kkostyy/cyberdeck/IDEAS.md

# Cyberdeck на Raspberry Pi 4 — что с ним можно сделать

Список идей для самодельного карманного компьютера (кибердеки): от рабочих задач до радио, железа и развлечений.
У каждой идеи указано, что понадобится, примерная цена, сложность и с чего начать.

**Сложность:** ★ — пара команд · ★★ — вечер настройки · ★★★ — проект на выходные и больше
**Цены** ориентировочные (евро, AliExpress / местные магазины, 2026).

---

## Что есть сейчас

| | |
|---|---|
| Плата | Raspberry Pi 4 Model B, 4 ГБ ОЗУ |
| Экран | 5" DSI 800×480, сенсорный (FT5x06) |
| Ввод | мини-клавиатура с тачпадом, экранная клавиатура, жесты от краёв |
| Связь | Wi-Fi, Bluetooth, Ethernet |
| Система | Arch Linux ARM, Wayland (sway) + оболочка serpantinum (quickshell) |
| Хранилище | microSD 16 ГБ |
| Софт | Claude Code (своё приложение claude-desk), VS Code, .NET 10 / ASP.NET Core, Chromium, kitty |

**Слабые места:** внезапные выключения из-за разъёма питания, мало места на SD-карте, нет батареи, нет звука на разъёме 3,5 мм (включается в `/boot/config.txt`).

---

## Содержание

1. [Сделать деку по-настоящему переносной](#1-сделать-деку-по-настоящему-переносной)
2. [Рабочая станция в кармане](#2-рабочая-станция-в-кармане)
3. [Радио и эфир](#3-радио-и-эфир)
4. [Сети](#4-сети)
5. [Железо через GPIO и USB](#5-железо-через-gpio-и-usb)
6. [Локальный ИИ без интернета](#6-локальный-ии-без-интернета)
7. [Камера и зрение](#7-камера-и-зрение)
8. [Навигация и поход](#8-навигация-и-поход)
9. [Электроника и ремонт](#9-электроника-и-ремонт)
10. [Развлечения и творчество](#10-развлечения-и-творчество)
11. [Дома на столе](#11-дома-на-столе)
12. [Обучение](#12-обучение)
13. [План: с чего начать](#13-план-с-чего-начать)
14. [Список покупок](#14-список-покупок)

---

## 1. Сделать деку по-настоящему переносной

### 1.1 Батарея / UPS ★★
**Что:** плата бесперебойного питания с аккумуляторами 18650 (или повербанк с режимом pass-through).
**Зачем:** дека работает без розетки, а при отходящем контакте Pi **не выключается** — UPS просто подхватывает питание. Это главный апгрейд.
**Нужно:** UPS HAT для Pi 4 (Waveshare UPS HAT, Geekworm X728/X1200, PiSugar для небольших сборок) + 2× аккумулятора 18650 с защитой. ~30–50 €.
**Что настроить:** индикатор заряда на панели, уведомление при низком заряде, аккуратное выключение при 5 %, автозапуск после подключения зарядки.
**Важно:** Pi 4 под нагрузкой берёт до 3 А — выбирать UPS с выходом не меньше 3 А.

### 1.2 Система на USB-флешке или SSD ★★
**Что:** перенос всей системы с microSD на USB 3.0-накопитель.
**Зачем:** в 3–5 раз быстрее запуск программ и установка пакетов, больше места, SD-карта перестаёт изнашиваться и не портится при выключениях.
**Нужно:** качественная флешка USB 3.x (SanDisk Extreme, Samsung BAR/FIT Plus, Kingston DataTraveler Max) или SSD M.2/SATA в USB-корпусе. 64 ГБ флешка — ~10–15 €, SSD 256 ГБ + корпус — ~30–40 €.
**Как:** тест скорости накопителя → копирование системы → загрузка с USB. SD-карта остаётся запасной.

### 1.3 Корпус ★★–★★★
**Что:** напечатанный на 3D-принтере или собранный корпус под экран, клавиатуру и батарею.
**Идеи:** раскладушка как у ноутбука, «чемоданчик» в стиле 80-х, наручный вариант. Готовые модели — на Printables/Thingiverse по запросу «cyberdeck 5 inch DSI».
**Плюс:** вывести наружу USB-порты, кнопку питания и светодиод состояния.

### 1.4 Кнопка питания и светодиод ★
**Что:** физическая кнопка на GPIO: короткое нажатие — экран вкл/выкл, долгое — корректное выключение. Светодиод показывает, что Pi работает или пишет на диск.
**Нужно:** кнопка + светодиод + резистор, ~2 €. Настройка — оверлеи `gpio-shutdown` и `gpio-led` в `/boot/config.txt`.

### 1.5 Охлаждение ★
**Что:** радиатор или вентилятор.
**Зачем:** в простое сейчас ~65 °C; при сборках и видео Pi упирается в 80 °C и сбрасывает частоту.
**Нужно:** радиаторы ~3 €, корпус-радиатор (Argon, Flirc) или вентилятор 30 мм ~5–15 €. Вентилятор можно включать по температуре через оверлей `gpio-fan`.

### 1.6 Энергосбережение ★
**Что:** режим «экономия» в один клик: ниже частота, без живых обоев, приглушённый экран, выключенный Bluetooth.
**Зачем:** +30–50 % времени работы от батареи.

---

## 2. Рабочая станция в кармане

### 2.1 Программирование где угодно ★
**Что уже есть:** Claude (claude-desk), VS Code, .NET 10, ASP.NET Core.
**Можно добавить:** Python с виртуальными окружениями, Node.js, Rust, Go, Git + GitHub CLI, Docker/Podman для маленьких сервисов.
**Идея:** «карманный стенд» — писать веб-API на ASP.NET и сразу открывать его с телефона по Wi-Fi.

### 2.2 Терминал для серверов ★
**Что:** SSH к другим машинам, tmux (сессии не рвутся при обрыве связи), mosh (SSH, который переживает смену сети), хранилище ключей.
**Зачем:** дека как «пульт» для домашнего сервера, VPS, роутера.

### 2.3 Офлайн-база знаний ★
**Что:** Kiwix — вся Википедия, Stack Overflow, Wiktionary, медицинские справочники без интернета.
**Размер:** Википедия на русском без картинок ~10 ГБ, английская с картинками ~100 ГБ. Нужен накопитель побольше (см. 1.2).

### 2.4 Заметки и личная база знаний ★
**Что:** Markdown-заметки в стиле Obsidian/Zettelkasten, синхронизация через git с телефоном и ПК.
**Плюс:** ежедневник, список дел, календарь (CalDAV — синхронизация с Google/Nextcloud).

### 2.5 Удалённый рабочий стол к ПК ★
**Что:** подключаться с деки к домашнему компьютеру (RDP/VNC/RustDesk) — дека как тонкий клиент к мощной машине.

### 2.6 Менеджер паролей ★
**Что:** KeePassXC с базой, синхронизируемой с телефоном (KeePassDX). Полностью офлайн.

---

## 3. Радио и эфир

> Приём почти везде законен. Передача — только на разрешённых частотах и/или с позывным (радиолюбительская лицензия).

### 3.1 SDR-приёмник ★★
**Что:** USB-свисток RTL-SDR превращает деку в радиоприёмник от 24 МГц до 1,7 ГГц.
**Что можно слушать и смотреть:**
- FM/AM-радио, авиадиспетчеров (118–137 МГц), морской канал;
- **ADS-B** — самолёты вокруг на карте в реальном времени (dump1090/readsb), можно отправлять данные во Flightradar24 и получать бесплатный бизнес-аккаунт;
- **метеоспутники NOAA/Meteor** — принимать снимки Земли из космоса (нужна простая антенна V-диполь);
- **rtl_433** — показания беспроводных термометров, метеостанций, датчиков вокруг;
- спектр эфира как «водопад» (SDR++, GQRX).

**Нужно:** RTL-SDR Blog V4 (~30–40 €) + антенны из комплекта.

### 3.2 Meshtastic / LoRa ★★
**Что:** текстовая связь на несколько километров (в городе 1–5 км, на открытой местности до 10+ км) без интернета и сотовой сети. Сообщения передаются по цепочке устройств (mesh).
**Нужно:** плата LoRa на 868 МГц (Европа): Heltec V3, LilyGO T-Beam (с GPS), RAK WisBlock — ~25–40 €. Подключается к деке по USB или Bluetooth.
**Идея:** дека как «базовая станция» сети Meshtastic с большим экраном и клавиатурой; приём сообщений даже когда телефон выключен.

### 3.3 Отслеживание спутников ★★
**Что:** Gpredict показывает, когда над тобой пролетает МКС и спутники. С SDR можно принимать SSTV-картинки с МКС (во время событий ARISS) и телеметрию.

### 3.4 Цифровые радиолюбительские режимы ★★★ (нужна лицензия на передачу)
**Что:** FT8 (связь через весь мир при мощности в несколько ватт), APRS (позиция и короткие сообщения), Winlink (e-mail через радио).
**Нужно:** трансивер + звуковой интерфейс (Digirig) — дека выступает «компьютером» станции.

---

## 4. Сети

> Сканировать и анализировать — только свои сети и с разрешения владельца.

### 4.1 Анализ Wi-Fi и Bluetooth ★
**Что:** какие сети вокруг, на каких каналах, уровень сигнала, загруженность каналов (полезно выбрать лучший канал для своего роутера). Список BLE-устройств поблизости.

### 4.2 Сетевая аптечка ★
**Что:** проверка своей домашней сети: какие устройства подключены (nmap), скорость между устройствами (iperf3), скорость интернета, просмотр трафика (Wireshark), DNS-диагностика.

### 4.3 Дорожный роутер ★★
**Что:** с дополнительным USB Wi-Fi-адаптером дека подключается к Wi-Fi отеля/кафе одним модулем, а другим раздаёт свою защищённую сеть для телефона и ноутбука — весь трафик через VPN.
**Нужно:** USB Wi-Fi-адаптер с поддержкой режима AP (чипы MediaTek MT7612U/MT7921AU) ~15–25 €.

### 4.4 Личный VPN / Tailscale ★
**Что:** доступ к деке из любой точки мира и с деки — к домашней сети, без проброса портов. WireGuard или Tailscale.

### 4.5 Учебная лаборатория по безопасности ★★
**Что:** CTF-задачи, TryHackMe/HackTheBox через VPN, свои виртуальные «мишени» — учиться защите сетей легально.

---

## 5. Железо через GPIO и USB

### 5.1 Датчики окружения ★
**Что:** температура, влажность, давление (BME280), CO₂ (SCD40), качество воздуха и пыль (PMS5003), освещённость.
**Результат:** показания на панели, графики за сутки/неделю, уведомление «пора проветрить».
**Нужно:** датчики ~5–40 € каждый, подключение по I²C.

### 5.2 Реле, свет, моторы ★★
**Что:** включать лампы и приборы (через реле — осторожно с 230 В!), управлять LED-лентами, сервоприводами, шаговыми моторами. Простые роботы и автоматизация.

### 5.3 Программатор микроконтроллеров ★
**Что:** прошивать Arduino, ESP32, ESP8266, Raspberry Pi Pico прямо с деки (arduino-cli, PlatformIO, esptool).
**Идея:** собрать с ESP32 беспроводные датчики, которые шлют данные на деку.

### 5.4 ИК-пульт ★
**Что:** универсальный пульт для телевизора, кондиционера, проектора (LIRC). Кнопки на экране деки.
**Нужно:** ИК-светодиод + ИК-приёмник ~3 €.

### 5.5 NFC/RFID ★★
**Что:** считыватель PN532: читать свои карты и метки, автоматизация («приложил метку — запустилось действие»), хранить данные визиток.
**Нужно:** PN532 ~5–8 €.

### 5.6 Bluetooth-датчики (BLE) ★
**Что:** читать дешёвые BLE-термометры (Xiaomi LYWSD03MMC ~5 €) по всей квартире без проводов.

### 5.7 Маленький дополнительный экран ★★
**Что:** OLED 0,96" или e-ink на корпусе: время, заряд, IP, уведомления — видно даже при выключенном основном экране.

---

## 6. Локальный ИИ без интернета

### 6.1 Небольшая языковая модель ★★
**Что:** llama.cpp с моделями 0,5–3 млрд параметров (Qwen, Llama, Gemma в квантизации Q4). Ответы офлайн, медленно (несколько слов в секунду), но работает без сети.
**Нужно:** место 1–3 ГБ на модель, лучше SSD.
**Идея:** офлайн-помощник в claude-desk, когда нет интернета.

### 6.2 Распознавание речи ★★
**Что:** Whisper (tiny/base) или Vosk — диктовка текста голосом в любое поле. Работает офлайн, на русском.
**Нужно:** USB-микрофон или гарнитура ~5–15 €.

### 6.3 Синтез речи ★
**Что:** Piper TTS — естественный голос на русском офлайн. Дека может зачитывать уведомления, книги, ответы Claude.

### 6.4 Голосовой ассистент ★★★
**Что:** связка 6.2 + 6.3 + команды: «включи свет», «какая погода», «сколько места на диске». Полностью локально.

---

## 7. Камера и зрение

**Нужно:** модуль Raspberry Pi Camera v3 (~25–35 €) или любая USB-вебкамера.

### 7.1 Сканер документов и текст из фото ★
**Что:** сфотографировал страницу — получил PDF и распознанный текст (Tesseract OCR, русский и английский).

### 7.2 Таймлапсы ★
**Что:** съёмка заката, роста растений, 3D-печати в виде ускоренного видео.

### 7.3 Датчик движения и охрана ★★
**Что:** Motion/Frigate — запись при движении, уведомление на телефон.

### 7.4 QR и штрихкоды ★
**Что:** считывать QR-коды камерой (Wi-Fi, ссылки), сканер штрихкодов для учёта вещей.

### 7.5 Астрофотография ★★★
**Что:** камера HQ + объектив или телескоп: Луна, планеты, звёздные треки.

---

## 8. Навигация и поход

### 8.1 GPS ★★
**Что:** USB- или UART-модуль GPS (u-blox NEO-M8N, ~10–20 €): координаты, скорость, высота, точное время даже без интернета.
**Применение:** запись треков поездок, привязка фото к месту, логгер прогулок.

### 8.2 Офлайн-карты ★★
**Что:** карты OpenStreetMap без интернета (GNOME Maps/Marble с офлайн-тайлами, свои MBTiles), маршруты.

### 8.3 «Тревожный чемоданчик» ★
**Что:** офлайн-набор: Википедия, справочник первой помощи, карты региона, инструкции по ремонту, важные документы в зашифрованном виде, Meshtastic для связи.

### 8.4 Дорожный журнал ★
**Что:** трек GPS + фото + заметки → автоматический дневник поездки с картой.

---

## 9. Электроника и ремонт

### 9.1 Логический анализатор ★★
**Что:** USB-анализатор на 8 каналов (~8–15 €) + PulseView/sigrok: смотреть сигналы I²C, SPI, UART при отладке устройств.

### 9.2 Консоль к устройствам ★
**Что:** USB-UART адаптер (CP2102/CH340, ~3 €): подключаться к роутерам, приставкам, платам по последовательному порту, восстанавливать прошивки.

### 9.3 Простой осциллограф ★★
**Что:** USB-осциллограф/звуковая карта как осциллограф — посмотреть форму сигнала, проверить питание.

### 9.4 Сервер для 3D-принтера ★★
**Что:** Klipper + Mainsail или OctoPrint — управлять 3D-принтером с деки, смотреть печать через камеру.

### 9.5 Диагностика авто ★★
**Что:** Bluetooth-адаптер OBD-II ELM327 (~10–15 €): коды ошибок машины, расход, температура, обороты в реальном времени на экране деки.

---

## 10. Развлечения и творчество

### 10.1 Ретро-игры ★
**Что:** RetroArch с эмуляторами NES, SNES, Sega, Game Boy/GBA, PS1, N64 (частично). Bluetooth-геймпад (8BitDo ~25–40 €).

### 10.2 Стриминг игр с ПК ★
**Что:** Moonlight — играть в тяжёлые игры с домашнего компьютера на экране деки по Wi-Fi.

### 10.3 Музыка и видео ★
**Что:** музыкальный плеер, подкасты, интернет-радио, Spotify Connect (spotifyd), видео.
**Сначала:** включить звук — «Настройки → Система → Звук» (разъём 3,5 мм) или Bluetooth-наушники.

### 10.4 Карманная музыкальная студия ★★
**Что:** синтезаторы (Surge XT, ZynAddSubFX), трекер (MilkyTracker), драм-машина, запись с микрофона. С USB-MIDI-клавиатурой — полноценный инструмент.

### 10.5 Читалка ★
**Что:** книги (FB2/EPUB/PDF), RSS-ленты, комиксы. Тёмная тема и крупный шрифт.

### 10.6 Пиксель-арт и рисование ★
**Что:** сенсорный экран + приложение для пиксель-арта (Pixelorama) или заметок от руки.

---

## 11. Дома на столе

### 11.1 Home Assistant ★★
**Что:** центр умного дома: свет, розетки, датчики, автоматизации, панель управления на экране деки.

### 11.2 Pi-hole / AdGuard Home ★
**Что:** блокировка рекламы и трекеров для всех устройств дома (DNS-фильтр).

### 11.3 Сетевая папка и бэкапы ★★
**Что:** Samba-шара, резервные копии телефонов и ПК (Syncthing — синхронизация без облака).

### 11.4 Инфо-панель (киоск) ★
**Что:** когда дека стоит на подставке: погода, календарь, курсы, состояние дома, загрузка ПК — на весь экран.

### 11.5 Сервер для своих проектов ★★
**Что:** держать на деке ASP.NET-API, бота для Telegram, веб-страницу; доступ через Tailscale или Cloudflare Tunnel.

---

## 12. Обучение

### 12.1 Linux и сети ★
**Что:** дека — идеальный «полигон»: изучать Linux, bash, systemd, сети, не боясь что-то сломать (есть бэкапы настроек).

### 12.2 Программирование ★
**Что:** C#/.NET, Python, веб, микроконтроллеры — с Claude как наставником прямо на деке.

### 12.3 Языки и карточки ★
**Что:** Anki (интервальные повторения), офлайн-словари, языковые курсы.

### 12.4 Электроника ★★
**Что:** наборы датчиков и макетная плата: от «мигнуть светодиодом» до своих устройств на ESP32.

---

## 13. План: с чего начать

| Этап | Что | Зачем |
|---|---|---|
| 1 | **Батарея / UPS** (1.1) | убирает внезапные выключения, дека становится переносной |
| 2 | **Перенос на USB/SSD** (1.2) | скорость и место под всё остальное |
| 3 | **Охлаждение** (1.5) | стабильная частота под нагрузкой |
| 4 | **SDR** (3.1) или **Meshtastic** (3.2) | самое «кибердечное»: эфир и связь без сети |
| 5 | **Датчики** (5.1) + **GPS** (8.1) | дека начинает «чувствовать» мир вокруг |
| 6 | **Локальный ИИ и голос** (6.1–6.3) | работа офлайн, управление голосом |

---

## 14. Список покупок

| Что | Для чего | Примерно |
|---|---|---|
| UPS HAT + 2×18650 | батарея, защита от выключений | 30–50 € |
| USB 3.0 флешка 64 ГБ / SSD | система, место | 10–40 € |
| Радиатор / вентилятор | охлаждение | 3–15 € |
| RTL-SDR Blog V4 | радиоприём, самолёты, спутники | 30–40 € |
| LoRa-плата 868 МГц (Heltec V3 / T-Beam) | Meshtastic | 25–40 € |
| GPS u-blox NEO-M8N | навигация, точное время | 10–20 € |
| BME280 / SCD40 | климат в комнате, CO₂ | 5–40 € |
| Камера Pi v3 | сканер, таймлапс, охрана | 25–35 € |
| USB-микрофон | голосовой ввод | 5–15 € |
| USB-UART + логический анализатор | электроника и ремонт | 10–20 € |
| ELM327 Bluetooth | диагностика авто | 10–15 € |
| Bluetooth-геймпад | ретро-игры | 25–40 € |

---

*Документ составлен вместе с Claude прямо на этой деке. Идеи можно брать по одной — каждая самостоятельная.*
