kkostyy/cyberdeck/CYBERDECK.md

# Cyberdeck на Raspberry Pi 4: полное описание проекта

Это общий документ по проекту: железо, система, экран, настройки, охлаждение, питание, корпус,
что уже сделано и что осталось. Файлы для печати корпуса и инструкция к ним лежат в [README.md](README.md).

Описание собрано по записи разговора от 2026-10-28. Это пересказ хода работы,
а не дословная выгрузка. Пароли и ключи Wi-Fi сюда не попали и попадать не должны.

> Конфиги ниже даны в том виде, в каком их обычно пишут для такой настройки. Перед тем как
> копировать их на Pi, сверьте с тем, что реально лежит в ваших файлах.

---

## Содержание

1. [Цель](#1-цель)
2. [Железо](#2-железо)
3. [Система и программы](#3-система-и-программы)
4. [Экран DSI 4,3"](#4-экран-dsi-43)
5. [Графическая сессия: Sway и Serpantinum](#5-графическая-сессия-sway-и-serpantinum)
6. [Удалённый доступ: SSH и WayVNC](#6-удалённый-доступ-ssh-и-wayvnc)
7. [Автовход на tty1](#7-автовход-на-tty1)
8. [Старый OLED 0,96"](#8-старый-oled-096)
9. [Охлаждение](#9-охлаждение)
10. [Питание](#10-питание)
11. [Корпус](#11-корпус)
12. [Клавиатура Rii mini X1](#12-клавиатура-rii-mini-x1)
13. [Список покупок и крепежа](#13-список-покупок-и-крепежа)
14. [Сборка по шагам](#14-сборка-по-шагам)
15. [Если что-то не работает](#15-если-что-то-не-работает)
16. [Безопасность](#16-безопасность)
17. [Что сделано и что дальше](#17-что-сделано-и-что-дальше)
18. [Идеи на потом](#18-идеи-на-потом)

---

## 1. Цель

Собрать компактный переносной компьютер-«кибердек»:

- Raspberry Pi 4 с Arch Linux ARM;
- графическая оболочка Serpantinum поверх Sway;
- маленький экран 4,3" прямо в корпусе;
- мини-клавиатура с тачпадом;
- работа от пауэрбанка и от провода;
- корпус-раскладушка, напечатанный на 3D-принтере, размером примерно 158 × 105 мм.

Попутно хотелось сделать маленький OLED-экранчик для системного монитора (температура, загрузка,
IP-адрес) и поставить вентилятор.

---

## 2. Железо

| Что | Модель / параметры | Статус |
|---|---|---|
| Компьютер | Raspberry Pi 4 Model B, 4 ГБ ОЗУ | работает |
| Основной экран | Waveshare 43H-800480-IPS, 4,3", 800×480, DSI, без тачскрина | работает |
| Доп. экран | OLED 0,96", 128×64, I²C, скорее всего SSD1306 | не показывает изображение |
| Клавиатура | Rii mini X1, 2,4 ГГц, с тачпадом, ~151 × 59 × 12,5 мм | есть |
| Питание | пауэрбанк 10 000 мА·ч, ~100 × 40 мм (толщина не измерена) | есть |
| Вентилятор | маленький, 5 В (25 или 30 мм) | обсуждался |
| Аккумулятор | 3,7 В, 400 мА·ч, рассматривался для экрана | не подходит напрямую, см. [раздел 10](#10-питание) |
| Принтер | 3D-принтер есть | есть |

### Размеры, которые важны для корпуса

| Деталь | Размер | Откуда |
|---|---|---|
| Raspberry Pi 4 | 85 × 56 мм, плата 1,4 мм, высота с USB/Ethernet ~17 мм | официальный чертёж |
| Отверстия Pi 4 | M2.5, сетка 58 × 49 мм, по 3,5 мм от краёв | официальный чертёж |
| Экран, плата | ~106 × 68 мм | оценка, **измерить** |
| Экран, видимая часть | ~96 × 55 мм | оценка, **измерить** |
| Клавиатура | 151 × 59 × 10…12,5 мм | разные магазины пишут по-разному, **измерить** |
| Пауэрбанк | 100 × 40 × ? мм | толщина неизвестна, **измерить** |

---

## 3. Система и программы

- **ОС:** Arch Linux ARM.
- **Ядро:** `linux-rpi 6.18.58-1`. Именно с ним заработал DSI-экран.
- **Пользователь:** `alarm` (стандартный в Arch Linux ARM).
- **Оболочка:** Serpantinum поверх композитора Sway (Wayland).
- **Браузер:** Chromium.
- **Веб-приложения:** Spotify и SoundCloud добавлены как веб-приложения Chromium.
- **Удалённый доступ:** SSH и WayVNC.

### Горячие клавиши Serpantinum

| Действие | Клавиши |
|---|---|
| Закрыть активное окно | `Win + Q` |
| Запасной вариант | `Alt + F4` |

### Полезные команды

```bash
# версия ядра
uname -r

# температура процессора (в тысячных долях градуса)
cat /sys/class/thermal/thermal_zone0/temp

# какие выходы видит Sway
swaymsg -t get_outputs

# обновить систему
sudo pacman -Syu
```

---

## 4. Экран DSI 4,3"

### Что было не так

Сначала экран показывал загрузочные сообщения ядра, а потом гас и оставался пустым. Причин две:

1. **Неподходящая конфигурация дисплея.** Нужен был правильный оверлей, а автоопределение DSI мешало.
2. **Графическая сессия запускалась на виртуальном выходе.** Sway рисовал картинку на «невидимый»
   экран 1280×720, который был нужен только для VNC, а физический DSI оставался пустым.

### Что сделали

1. Поставили ядро `linux-rpi 6.18.58-1`.
2. В `/boot/config.txt` включили оверлей для Waveshare и отключили автоопределение:

   ```ini
   display_auto_detect=0
   dtoverlay=vc4-kms-v3d
   dtoverlay=vc4-kms-dsi-waveshare-800x480,disable_touch
   ```

   `disable_touch` нужен потому, что у этой модели тачскрина нет.

3. После перезагрузки система стала видеть выход `DSI-1` с разрешением 800×480 как подключённый.
4. Sway перенаправили на физический DSI.
5. Выставили масштаб `0.625`, чтобы интерфейс Serpantinum целиком помещался на маленьком экране.

### Про масштаб 0.625

Масштаб меньше 1 делает «логический» экран больше физического: 800 / 0,625 = 1280, 480 / 0,625 = 768.
Интерфейс думает, что экран 1280×768, и всё помещается, но элементы и шрифты становятся мельче.

| Масштаб | Логическое разрешение | Как выглядит |
|---|---|---|
| 1.0 | 800×480 | крупно, интерфейс может не влезть |
| 0.8 | 1000×600 | компромисс |
| 0.625 | 1280×768 | всё влезает, но мелко (сейчас так) |

Подбирать удобнее всего на живом экране:

```bash
swaymsg output DSI-1 scale 0.8
```

Когда найдёте удачное значение, запишите его в конфиг Sway.

---

## 5. Графическая сессия: Sway и Serpantinum

Примерно так выглядят нужные строки в конфиге Sway (`~/.config/sway/config`):

```text
# физический экран
output DSI-1 resolution 800x480 scale 0.625

# оболочка Serpantinum — полный путь обязателен
exec /home/alarm/.local/bin/serpantinumd

# VNC-сервер стартует вместе с сессией
exec wayvnc 0.0.0.0 5900
```

### Важные детали

- **Полный путь к Serpantinum.** Автозапуск не работал, пока в конфиге было просто `serpantinumd`:
  при старте Sway папки `~/.local/bin` может не быть в `PATH`. Теперь путь указан целиком:
  `/home/alarm/.local/bin/serpantinumd`.
- **Проверка.** Снимок экрана после настройки показал Serpantinum на DSI, все элементы влезали в кадр.

---

## 6. Удалённый доступ: SSH и WayVNC

### SSH

Работает. Подключение с компьютера в той же сети:

```bash
ssh alarm@<IP-адрес-Pi>
```

### WayVNC

- WayVNC теперь запускается **из конфига Sway**, то есть показывает тот же экран, что и DSI.
- Раньше был отдельный пользовательский systemd-сервис, который поднимал свой виртуальный экран
  1280×720. Именно из-за него картинка уходила «в никуда». Этот сервис **отключён**.
- Клиент RealVNC на Windows раньше выдавал отказ соединения. Это стоит перепроверить после
  перезагрузки (см. [раздел 17](#17-что-сделано-и-что-дальше)).

Если VNC не подключается:

```bash
# слушает ли wayvnc порт
ss -tlnp | grep 5900

# не запущен ли где-то старый сервис
systemctl --user list-units | grep -i vnc
```

---

## 7. Автовход на tty1

Чтобы после включения сразу запускался Sway, настроен автоматический вход пользователя `alarm` на `tty1`.
Обычно это делается через override для getty:

```ini
# /etc/systemd/system/getty@tty1.service.d/autologin.conf
[Service]
ExecStart=
ExecStart=-/sbin/agetty -o '-p -f -- \\u' --noclear --autologin alarm %I $TERM
```

Плюс в `~/.bash_profile` запуск Sway при входе на первую консоль:

```bash
if [ -z "$WAYLAND_DISPLAY" ] && [ "$XDG_VTNR" = 1 ]; then
    exec sway
fi
```

> **Минус:** любой, у кого Pi окажется в руках, сразу попадает в вашу сессию без пароля. Для дома
> это нормально, для устройства, которое носите с собой, стоит подумать о блокировке экрана
> (например, swaylock).

---

## 8. Старый OLED 0,96"

### Параметры

- 0,96", 128×64 точки, интерфейс I²C, контроллер предположительно SSD1306.

### Подключение к Pi

| OLED | Pi | Физический контакт |
|---|---|---|
| VCC | 3,3 В | 1 |
| GND | GND | 6 (или 9) |
| SDA | GPIO2 (SDA1) | 3 |
| SCL | GPIO3 (SCL1) | 5 |

### Что было

- Написали программу системного монитора и службу `cyberdeck-oled.service`.
- Служба запускалась без ошибок, но на матрице ничего не появлялось.
- Есть подозрение, что матрица сгорела после пайки.

### Что сейчас

- Служба **остановлена и отключена**: `systemctl disable --now cyberdeck-oled.service`.
- На DSI-экран она никак не влияет.

### Как проверить, жив ли OLED

1. **Выключите Pi** и только потом проверяйте пайку.
2. Посмотрите маркировку модуля: некоторые модули рассчитаны только на 3,3 В, некоторые на 3,3–5 В.
   Не меняйте напряжение наугад.
3. Проверьте пайку на замыкания мультиметром: VCC–GND не должны звониться накоротко.
4. Включите I²C (`dtparam=i2c_arm=on` в `/boot/config.txt`) и посмотрите, видит ли Pi модуль:

   ```bash
   sudo pacman -S i2c-tools
   sudo i2cdetect -y 1
   ```

   SSD1306 обычно отвечает по адресу `0x3c` (реже `0x3d`).
   - Адрес виден, а картинки нет: скорее всего проблема в программе или в самой матрице.
   - Адреса нет: проблема в пайке, проводах или контроллере модуля.

5. Только когда всё проверено, включайте службу обратно.

В корпусе можно оставить под OLED окно примерно 27 × 15 мм, но пока это не сделано: сначала надо
понять, жив ли модуль.

---

## 9. Охлаждение

- Температура Pi в проверках была **56–60 °C**. Это нормально, срочного охлаждения не требуется.
- В закрытом корпусе тепло будет копиться, поэтому нужен отвод воздуха.
- Pi 4 начинает сбрасывать частоту примерно с 80 °C.

### Вентилятор 5 В

- Подключать **только к контактам питания**: красный провод к 5 В (контакт 2 или 4), чёрный к GND (контакт 6).
- **Не** подключать к сигнальным GPIO: они не рассчитаны на такой ток.
- Подключать **при выключенной плате**.
- Если вентилятор шумит, можно запитать его от 3,3 В (контакт 1): крутится медленнее и тише,
  но не каждый вентилятор на 5 В от этого стартует.

### В корпусе

- Вентилятор 25 мм стоит на левой стенке и выдувает воздух наружу.
- Воздух заходит через щели в дне под Pi и через щели на правой стенке.
- Над электроникой в полке тоже есть щели.
- Для вентилятора 30 мм корпус придётся сделать выше: параметр `fan = 30` в модели.

Проверка температуры под нагрузкой:

```bash
watch -n 2 'cat /sys/class/thermal/thermal_zone0/temp'
```

---

## 10. Питание

### Что нужно Raspberry Pi 4

- **5 В, до 3 А** через USB-C.
- Если питания не хватает, в логах появляются предупреждения о пониженном напряжении (under-voltage),
  а система работает нестабильно.

```bash
# 0x0 — всё хорошо, любое другое значение — были проблемы с питанием
vcgencmd get_throttled
```

### Пауэрбанк 10 000 мА·ч

- Основной источник питания в корпусе.
- От него к Pi идёт короткий **угловой USB-C кабель**: между Pi и пауэрбанком оставлено 16 мм.
- Разъём пауэрбанка выведен в задний вырез, чтобы заряжать его снаружи.
- **Работа от провода:** удобнее всего, если пауэрбанк умеет **сквозную зарядку** (pass-through),
  то есть заряжается и одновременно отдаёт ток. Многие дешёвые пауэрбанки так не умеют: при
  подключении зарядки они на секунду отключают выход, и Pi перезагружается. Проверьте это до сборки.
- Если сквозной зарядки нет, Pi можно питать от сетевого блока напрямую, но для этого придётся
  вынимать угловой кабель.
- Если «акум от повера» означает, что банку достают из корпуса пауэрбанка: голая литиевая банка даёт
  3,7 В, а Pi нужно 5 В. Без платы пауэрбанка (повышающий преобразователь, зарядка, защита) такая банка
  работать не будет. Плату нужно оставлять вместе с банкой.

### Аккумулятор 3,7 В, 400 мА·ч для экрана

Обсуждали отдельный аккумулятор и отдельную кнопку питания для экрана. Выводы:

- Экран Waveshare DSI питается от самой Pi через DSI-шлейф (и/или 5 В с гребёнки), отдельное питание
  ему обычно не нужно.
- Аккумулятор 3,7 В нельзя подключать к экрану напрямую: нужна плата зарядки с защитой
  (например, на TP4056 с защитой) и повышающий преобразователь до 5 В.
- 400 мА·ч — это очень мало: экран с подсветкой съест такую банку быстро.
- Прежде чем что-то делать, нужно найти в паспорте экрана напряжение питания и максимальный ток.

**Вывод:** проще и надёжнее питать всё от одного пауэрбанка.

---

## 11. Корпус

Модель и файлы для печати лежат в этом репозитории, подробности в [README.md](README.md).

### Общий вид

- **Раскладушка**, как маленький ноутбук, 158 × 106 мм.
- Высота: основание ~42 мм, крышка ~12 мм, в закрытом виде ~54 мм. Цифры зависят от толщины
  пауэрбанка и клавиатуры.
- Сделан в **OpenSCAD**: размеры меняются числами в начале файла `cyberdeck_case.scad`.

### Что где лежит (вид сверху)

```text
        задняя стенка: [USB+Ethernet Pi]     [разъём пауэрбанка]
  ┌─────────────────────────────────────────────────────────┐
  │                 ┌──────────┐        ┌──────────────┐   │
  │  вентилятор     │          │ угловой│              │   │
  │  25 мм          │ Raspberry│  USB-C │  пауэрбанк   │   │  ← щели
 ◄│  (выдув)        │  Pi 4    │ 16 мм  │  100 × 40    │   │
  │                 │          │        │              │   │
  │  запас DSI-     │          │        │              │   │
  │  шлейфа         └──────────┘        └──────────────┘   │
  └─────────────────────────────────────────────────────────┘
               передняя стенка (вырез, чтобы вынимать клавиатуру)

  выше всего этого лежит полка, а на ней клавиатура Rii mini X1
```

### Детали

| Деталь | Файл | Как печатать |
|---|---|---|
| Основание | `base.stl` | дном на стол, без поддержек |
| Полка под клавиатуру | `deck.stl` | плоско |
| Крышка с окном экрана | `lid.stl` | лицом на стол, поддержки только под петлями |
| Задняя крышка экрана | `lid_cover.stl` | плоско |

### Настройки печати

- **PETG**, а не PLA: PLA размягчается около 55–60 °C, а внутри корпуса рядом с Pi примерно столько и бывает.
- Слой 0,2 мм, 3 периметра, заполнение 20 %.
- Перед печатью всего корпуса напечатайте только основание и проверьте, как в нём лежат Pi и пауэрбанк.

### Петли

- Две петли по бокам, ось — болт M3 × 25 с гайкой.
- Затяните гайку так, чтобы крышка держала угол, но открывалась рукой.
- Крышка открывается почти на 180°.

### DSI-шлейф

- Идёт от разъёма DISPLAY на Pi через щель в полке и щель в крышке к экрану.
- Шлейф, который идёт в комплекте с экраном, скорее всего коротковат. Нужен 15-pin FFC длиной около 20 см.
- Шлейф гнётся при каждом открытии крышки, поэтому оставьте ему свободную петлю и не перегибайте под острым углом.

### Параметры модели, которые стоит поправить

| Параметр | Сейчас | Что это |
|---|---|---|
| `pb` | `[40, 100, 22]` | ширина, длина, толщина пауэрбанка |
| `kb` | `[151, 59, 12.5]` | клавиатура |
| `scr_board` | `[106, 68]` | плата экрана |
| `scr_view` | `[96, 55]` | окно под видимую часть экрана |
| `scr_stack` | `8` | толщина экрана вместе с деталями на обороте |
| `fan` | `25` | размер вентилятора |
| `usbc_gap` | `16` | место под угловой USB-C |
| `dsi_slot_c` | `[70, 92]` | где щель под шлейф |

После правки STL пересобираются так:

```bash
openscad -D 'part="base"' -o base.stl cyberdeck_case.scad
openscad -D 'part="deck"' -o deck.stl cyberdeck_case.scad
openscad -D 'part="lid"' -o lid.stl cyberdeck_case.scad
openscad -D 'part="lid_cover"' -o lid_cover.stl cyberdeck_case.scad
```

---

## 12. Клавиатура Rii mini X1

- Беспроводная, 2,4 ГГц, подключается через USB-донгл. Донгл вставляется в один из USB-портов Pi на задней стенке.
- Есть тачпад, поэтому отдельная мышь не нужна.
- В корпусе лежит на полке, вровень с краем основания, и вынимается за вырез спереди.
- Перед печатью измерьте толщину: в разных магазинах указано от 10 до 12,5 мм. От этого зависит высота корпуса.

---

## 13. Список покупок и крепежа

| Что | Сколько | Для чего |
|---|---|---|
| PETG-пластик | ~150 г | корпус |
| Саморез M2.5 × 6 | 4 | Pi на стойки |
| Винт M3 × 6, потай | 2 | полка |
| Винт M3 × 8, потай | 4 | задняя крышка экрана |
| Болт M3 × 25 + гайка (лучше с нейлоновой вставкой) | 2 | петли |
| Резиновые ножки | 4 | под дно, чтобы работали вентиляционные щели |
| Угловой кабель USB-C ↔ выход пауэрбанка, ~15 см | 1 | питание Pi |
| Шлейф FFC 15-pin, ~20 см | 1 | экран |
| Вентилятор 5 В, 25 мм | 1 | охлаждение |
| Радиаторы на Pi | комплект | по желанию |

---

## 14. Сборка по шагам

1. Напечатайте основание и примерьте в нём Pi и пауэрбанк.
2. Если всё влезло, напечатайте остальные детали.
3. Прикрутите Pi к стойкам саморезами M2.5.
4. Вставьте пауэрбанк справа, разъёмом к заднему вырезу.
5. Соедините пауэрбанк и Pi угловым USB-C кабелем.
6. Поставьте вентилятор на левую стенку и подключите его к 5 В и GND **при выключенной Pi**.
7. Подключите DSI-шлейф к Pi и проведите его через щель в полке.
8. Положите полку на выступы и прикрутите винтами M3 × 6.
9. Вставьте экран в рамку крышки, проведите шлейф через щель и подключите к экрану.
10. Закройте экран задней крышкой (M3 × 8).
11. Соедините основание и крышку болтами M3 × 25 и подтяните гайки.
12. Вставьте USB-донгл клавиатуры в Pi и положите клавиатуру на полку.
13. Наклейте ножки на дно.
14. Включите и проверьте температуру под нагрузкой.

---

## 15. Если что-то не работает

| Проблема | Что проверить |
|---|---|
| Экран показывает загрузку и гаснет | оверлей в `/boot/config.txt`, `display_auto_detect=0`, Sway выводит на `DSI-1`, а не на виртуальный выход |
| Экран вообще пустой | шлейф (контакты в нужную сторону), защёлки разъёмов, `swaymsg -t get_outputs` |
| Serpantinum не стартует | полный путь `/home/alarm/.local/bin/serpantinumd` в конфиге Sway |
| VNC показывает не тот экран | отключён ли старый VNC-сервис с виртуальным экраном 1280×720 |
| VNC отказывает в соединении | запущен ли wayvnc (`ss -tlnp`), правильный ли IP, нет ли файрвола |
| Всё слишком мелко | поднять масштаб: `swaymsg output DSI-1 scale 0.8` |
| Pi перезагружается при подключении зарядки | пауэрбанк не умеет сквозную зарядку |
| Молния на экране / `get_throttled` ≠ 0x0 | слабое питание или плохой кабель |
| OLED пустой | `i2cdetect -y 1`, пайка, напряжение модуля (см. [раздел 8](#8-старый-oled-096)) |
| Окно не закрывается | `Win + Q`, запасной вариант `Alt + F4` |

---

## 16. Безопасность

- Всё, что связано с пайкой и проводами, делать **только при выключенном питании**.
- Не соединять VCC и GND наугад. Сначала посмотреть маркировку и распиновку.
- Не подавать 5 В на модули, рассчитанные на 3,3 В.
- Не подключать голую литиевую банку без платы защиты и зарядки.
- Не прокалывать и не сжимать аккумуляторы в корпусе: пауэрбанк должен лежать свободно, без давления.
- Пароли, ключи Wi-Fi и SSH-ключи в этот репозиторий не класть.

---

## 17. Что сделано и что дальше

### Сделано

- [x] Arch Linux ARM на Raspberry Pi 4
- [x] Ядро `linux-rpi 6.18.58-1`
- [x] DSI-экран работает (`DSI-1`, 800×480)
- [x] Sway выводит на физический экран, масштаб 0.625
- [x] Автозапуск Serpantinum по полному пути
- [x] WayVNC запускается из конфига Sway, старый сервис с виртуальным экраном отключён
- [x] Автовход `alarm` на `tty1`
- [x] Chromium, Spotify и SoundCloud как веб-приложения
- [x] OLED-служба остановлена и не мешает
- [x] Модель корпуса в OpenSCAD и STL-файлы

### Дальше

- [ ] Проверить на самом экране, читается ли интерфейс при масштабе 0.625, и подобрать удобный масштаб
- [ ] Проверить, что WayVNC доступен из локальной сети после перезагрузки
- [ ] Измерить толщину пауэрбанка, клавиатуру и плату экрана, поправить модель
- [ ] Проверить, умеет ли пауэрбанк сквозную зарядку
- [ ] Купить угловой USB-C и длинный DSI-шлейф
- [ ] Напечатать основание и примерить
- [ ] Напечатать остальные детали и собрать
- [ ] Проверить температуру в закрытом корпусе под нагрузкой
- [ ] Проверить OLED (`i2cdetect`), и только потом включать его службу

---

## 18. Идеи на потом

- **Окно под OLED** в корпусе, если модуль окажется живым: температура, загрузка, IP-адрес, заряд.
- **Индикатор заряда:** некоторые пауэрбанки отдают уровень заряда, можно вывести его на OLED или в панель.
- **Кнопка питания** с безопасным выключением через GPIO3 (`dtoverlay=gpio-shutdown`).
- **Ремешок или ручка** на корпусе.
- **Наклейки и покраска** в «кибер»-стиле.
- **Блокировка экрана** (swaylock) из-за автовхода.
- **Тачскрин:** если когда-нибудь поменять экран на версию с сенсором, убрать `disable_touch`.
