kkostyy/cyberdeck/ashenos/docs/STATUS.md

# Что готово в AshenOS

Обновлено: 11 ноября 2026.

Проект состоит из двух частей, и важно их не путать:

- **Прототип** (`design/prototype`, открывается в Claude Design) — как система должна выглядеть и
  работать. Всё, что ниже отмечено «прототип», пока существует только там.
- **Дистрибутив** (`airootfs`, `build`, `apps`) — то, что реально попадает в образ для Raspberry Pi.

| Часть | Прототип | Дистрибутив | Проверено на Pi |
|---|---|---|---|
| Экран блокировки (пароль, PIN, лицо) | ✅ | SDDM с тёмной темой | ❌ |
| Рабочий стол, виджеты, Dock | ✅ адаптивные | Plasma 6 + своя тема | ❌ |
| Dynamic Island и полка файлов | ✅ | ✅ `usr/share/ashenos/island` (Quickshell: музыка, громкость, батарея, таймер, полка) | ❌ |
| Панель «Сегодня», фокус и задачи | ✅ | ❌ | — |
| Подстройка под размер экрана (800×480 … 1920×1080) | ✅ | масштаб Plasma (`SCALE`) | ❌ |
| Жесты, привязка окон, рабочие столы, обзор окон | ✅ | ✅ настроено в `kwinrc` и `kglobalshortcutsrc` | ❌ |
| Тема значков Ashen | ✅ | ✅ `usr/share/icons/ashen` | ❌ |
| Светлое оформление и системные звуки | ✅ | ❌ | — |
| Параметры в стиле macOS | ✅ | `ashenos-settings` (консоль + окно) | ❌ |
| Проводник | ✅ | Dolphin | ❌ |
| Блокнот | ✅ | Kate | ❌ |
| Калькулятор | ✅ | KCalc | ❌ |
| Фото и видео | ✅ | Gwenview / mpv | ❌ |
| Карты | ✅ | ✅ `ashen-maps` (QML, OSM) | ❌ |
| Монитор системы | ✅ | Plasma System Monitor | ❌ |
| Умный диспетчер задач (советы, «Освободить память», Ctrl+Shift+Esc) | ✅ | Plasma System Monitor, без советов | ❌ |
| Claude | ✅ | ✅ `claude-desk` | ❌ |
| Первый запуск | — | ✅ `ashenos-firstboot` | ❌ |

## Ближайшие шаги

1. Собрать образ и пройти [чек-лист проверки на железе](HARDWARE-CHECKLIST.md).
2. Проверить остров на железе и перенести панель «Сегодня» (фокус и задачи из заметок).
4. Решить, нужны ли свои Калькулятор, Блокнот и Фото в образе, или хватит приложений KDE
   с темой Ashen.
