kkostyy/cyberdeck/ashenos/airootfs/usr/share/wallpapers/ashenos/lava.jpg

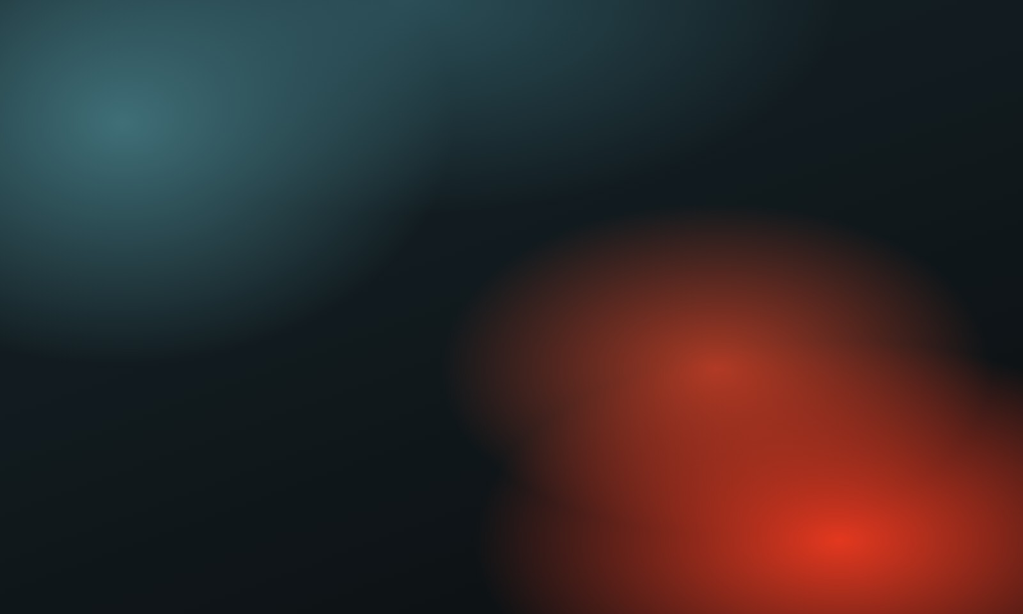
ashenos/airootfs/usr/share/wallpapers/ashenos/lava.jpg
