kkostyy/cyberdeck/ashenos/airootfs/usr/share/wallpapers/ashenos/orange.jpg

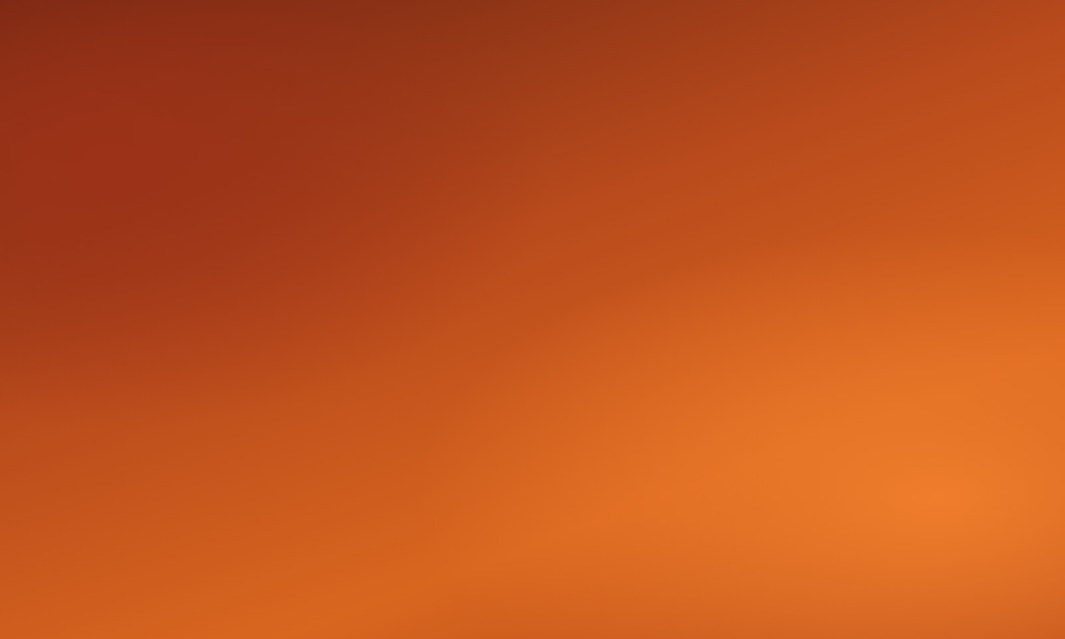
ashenos/airootfs/usr/share/wallpapers/ashenos/orange.jpg
