kkostyy/cyberdeck/ashenos/airootfs/usr/share/wallpapers/ashenos/rainbow.jpg

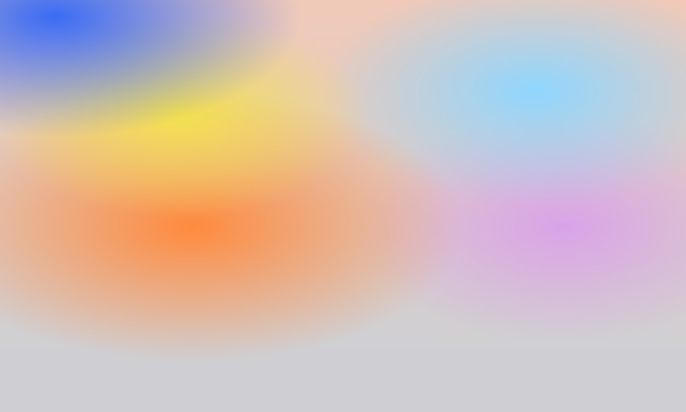
ashenos/airootfs/usr/share/wallpapers/ashenos/rainbow.jpg
