kkostyy/cyberdeck/ashenos/airootfs/usr/share/wallpapers/ashenos/silk.jpg

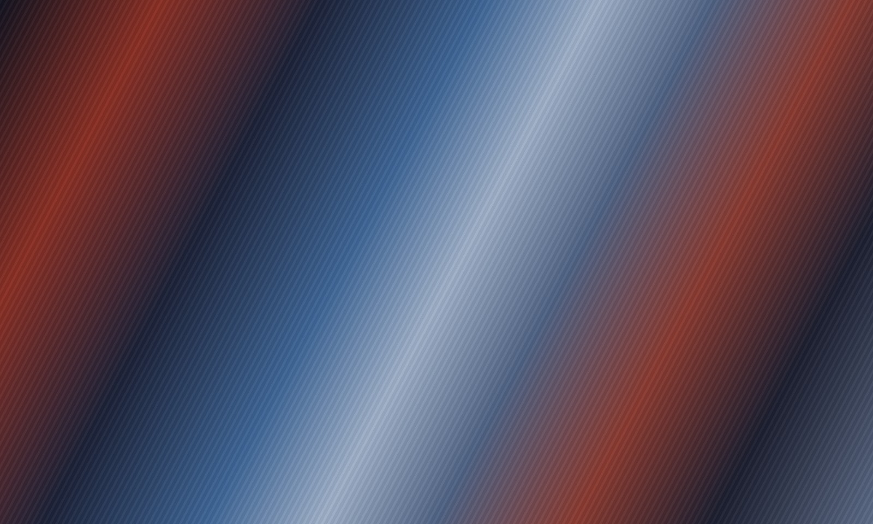
ashenos/airootfs/usr/share/wallpapers/ashenos/silk.jpg
