kkostyy/cyberdeck/ashenos/airootfs/usr/share/wallpapers/ashenos/waves.jpg

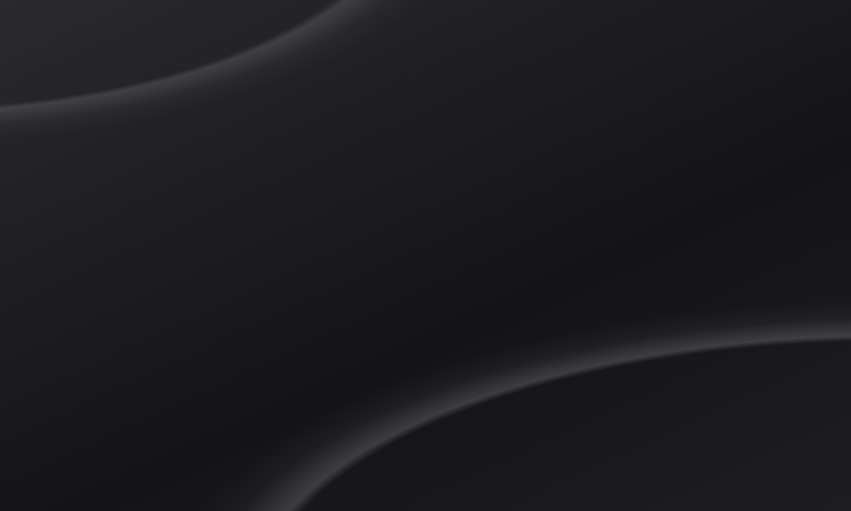
ashenos/airootfs/usr/share/wallpapers/ashenos/waves.jpg
