kkostyy/cyberdeck/ashenos/design/brand/sheet.png

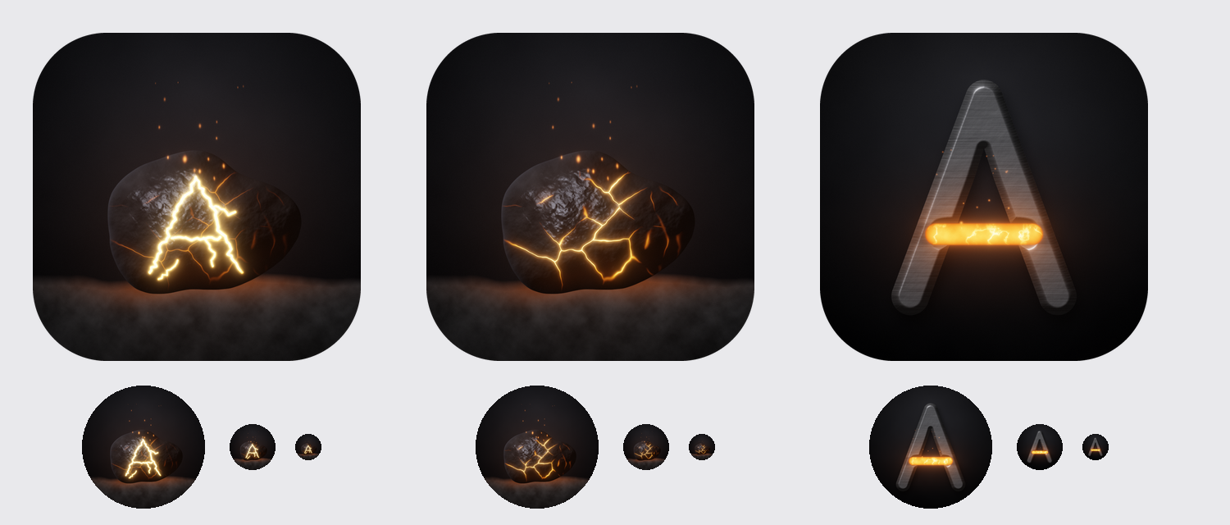
ashenos/design/brand/sheet.png
