kkostyy/cyberdeck/ashenos/design/prototype/media/alps.jpg

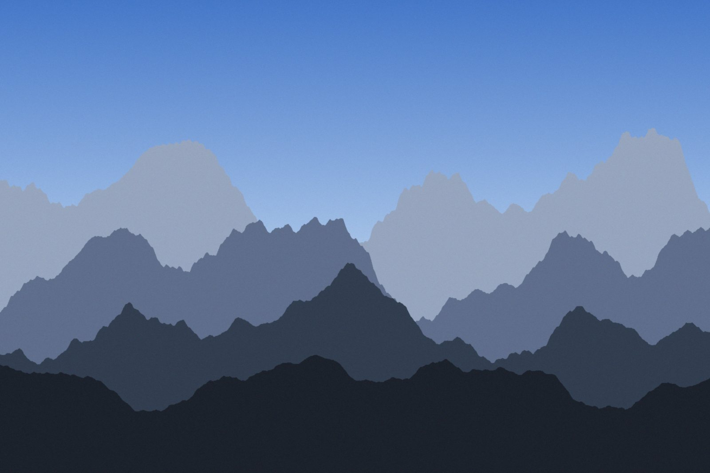
ashenos/design/prototype/media/alps.jpg
