kkostyy/cyberdeck/ashenos/design/prototype/media/aurora.jpg

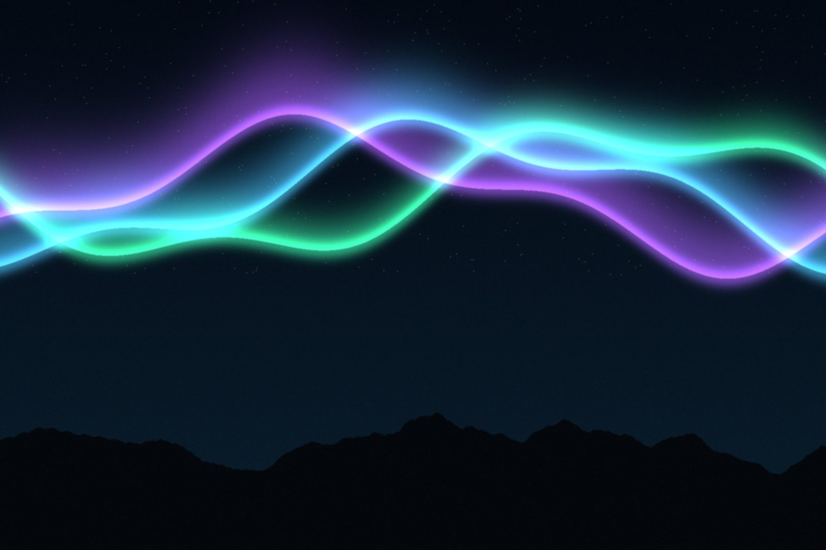
ashenos/design/prototype/media/aurora.jpg
