kkostyy/cyberdeck/ashenos/design/prototype/media/city.jpg

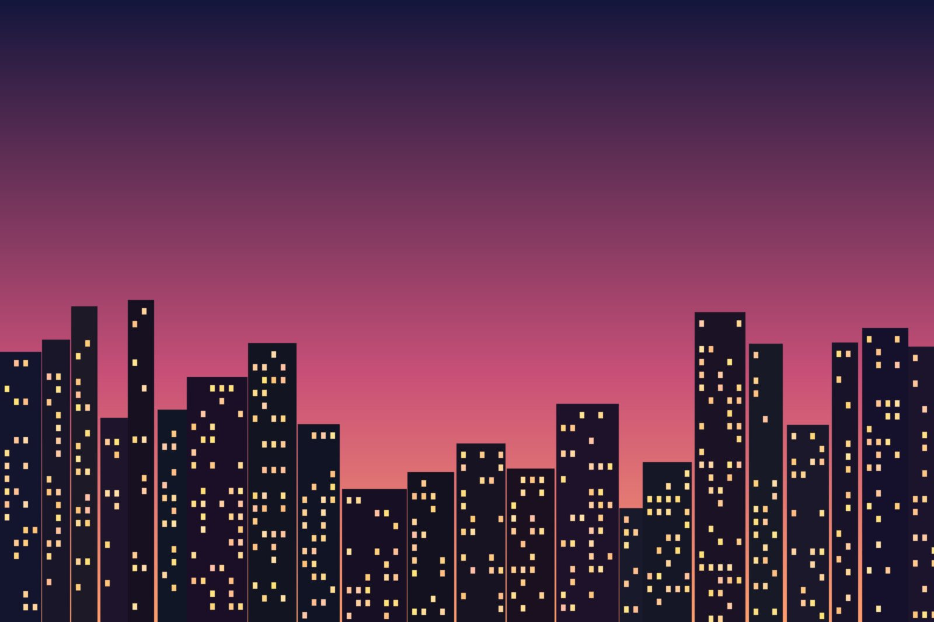
ashenos/design/prototype/media/city.jpg
