kkostyy/cyberdeck/ashenos/design/prototype/media/clip-aurora.jpg

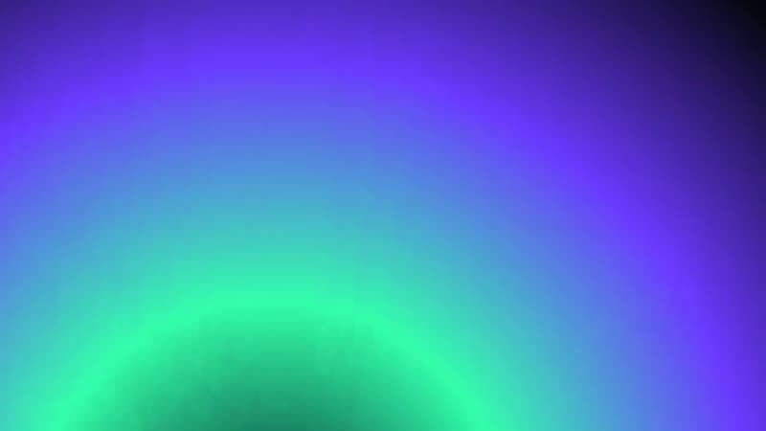
ashenos/design/prototype/media/clip-aurora.jpg
