kkostyy/cyberdeck/ashenos/design/prototype/media/clip-sunset.jpg

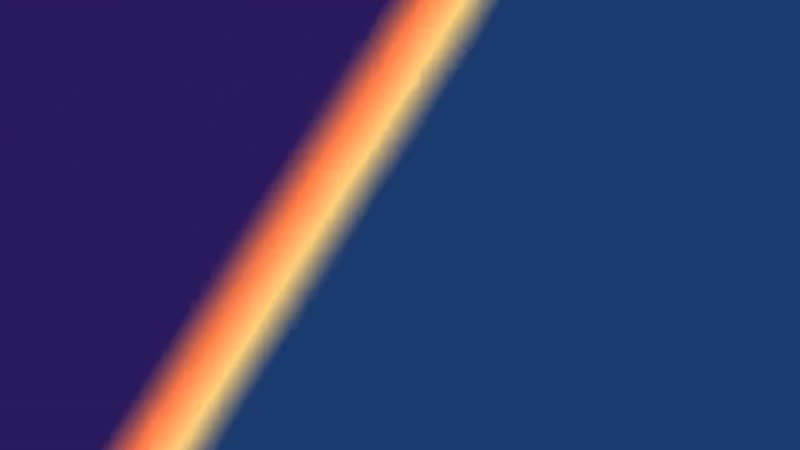
ashenos/design/prototype/media/clip-sunset.jpg
