kkostyy/cyberdeck/ashenos/design/prototype/media/dawn.jpg

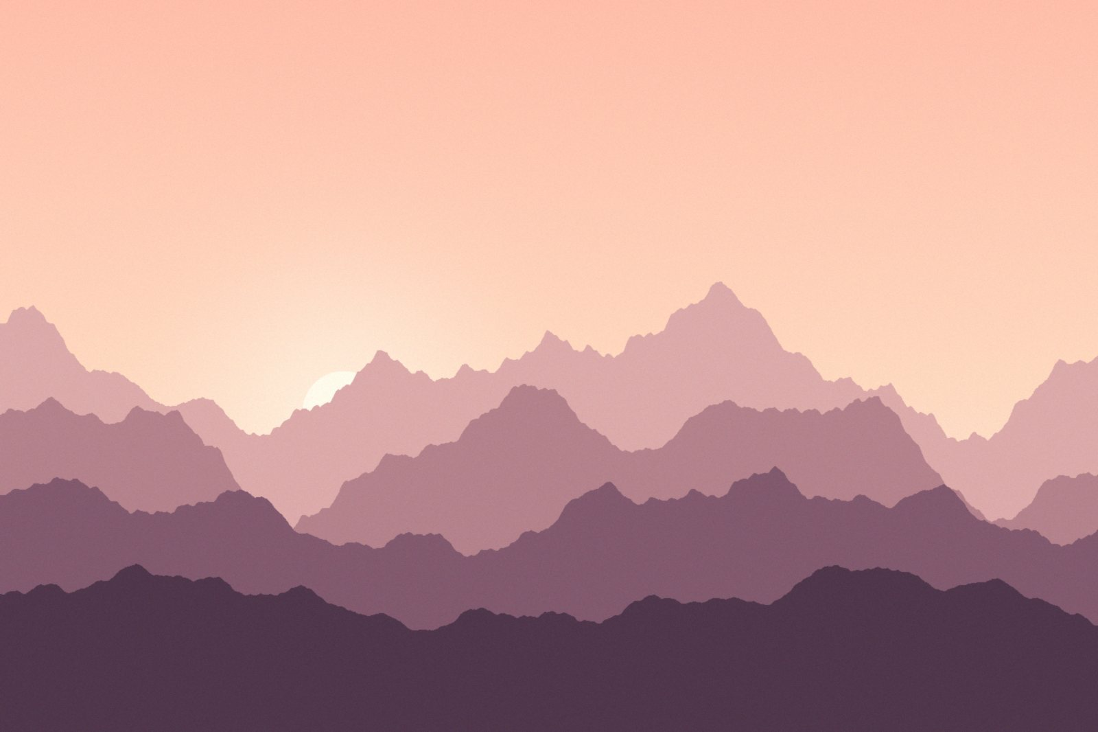
ashenos/design/prototype/media/dawn.jpg
