kkostyy/cyberdeck/ashenos/design/prototype/media/dunes.jpg

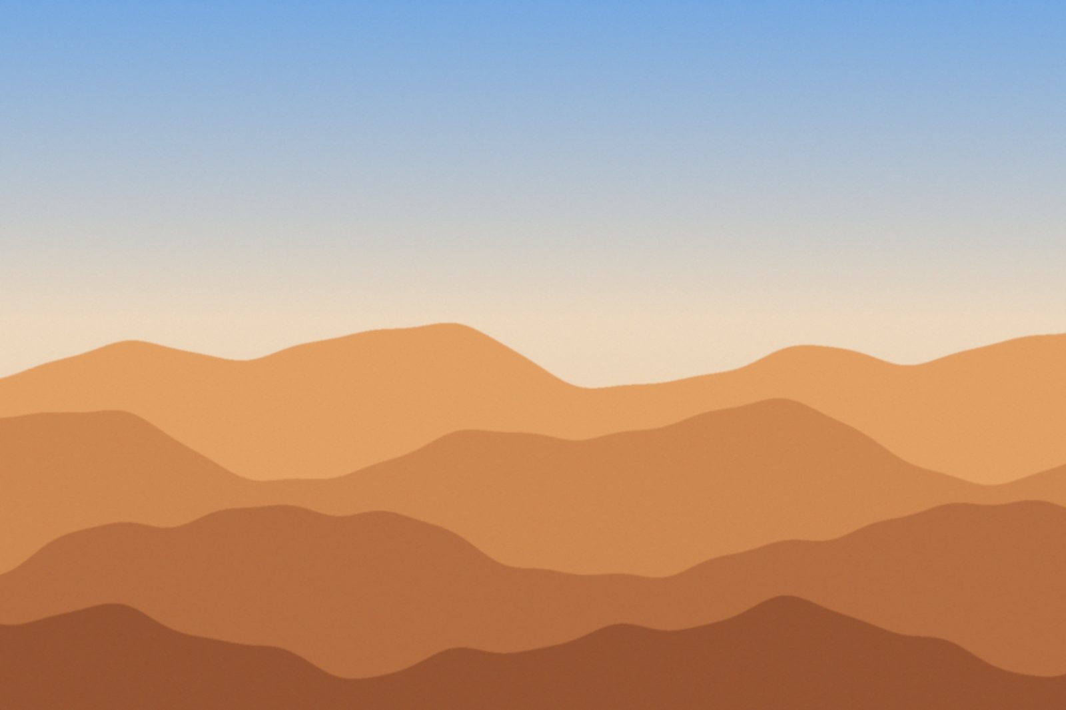
ashenos/design/prototype/media/dunes.jpg
