kkostyy/cyberdeck/ashenos/design/prototype/media/forest.jpg

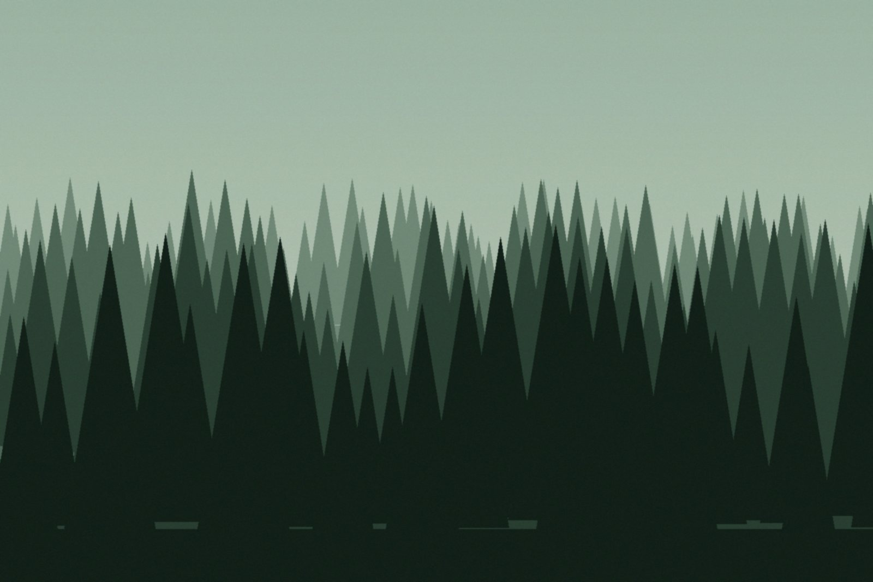
ashenos/design/prototype/media/forest.jpg
