kkostyy/cyberdeck/ashenos/design/prototype/media/lake.jpg

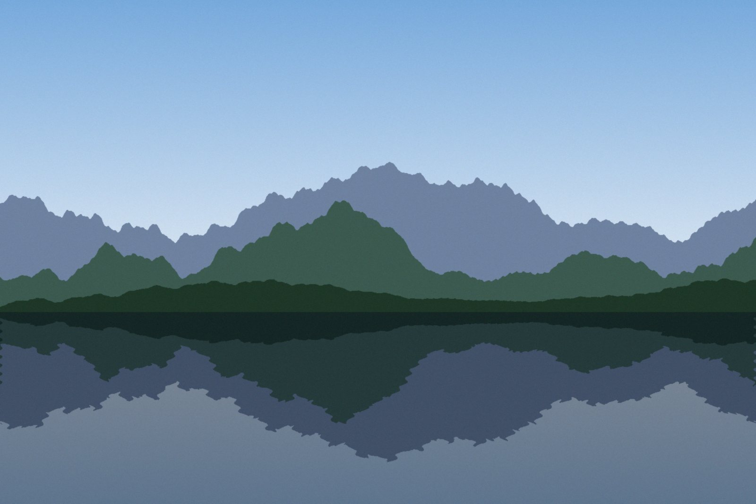
ashenos/design/prototype/media/lake.jpg
