kkostyy/cyberdeck/ashenos/design/prototype/media/night.jpg

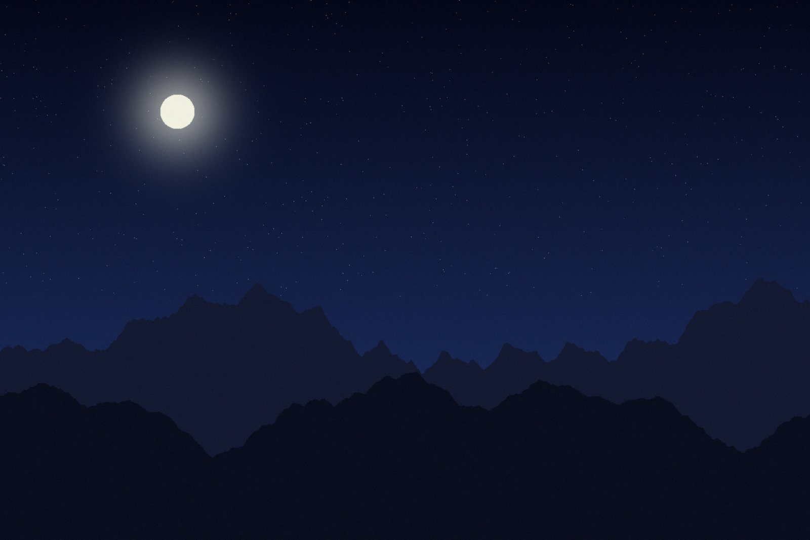
ashenos/design/prototype/media/night.jpg
