kkostyy/cyberdeck/ashenos/design/prototype/media/ocean.jpg

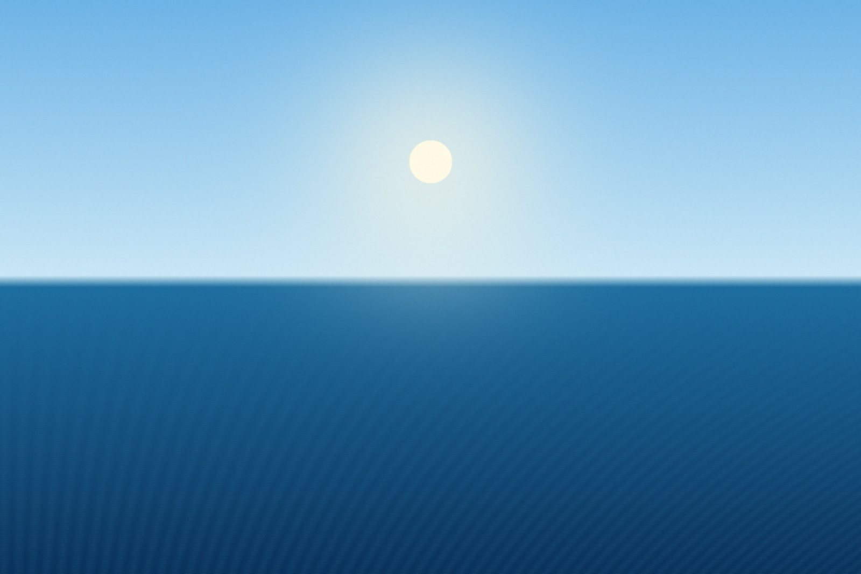
ashenos/design/prototype/media/ocean.jpg
