kkostyy/cyberdeck/ashenos/design/prototype/media/sunset.jpg

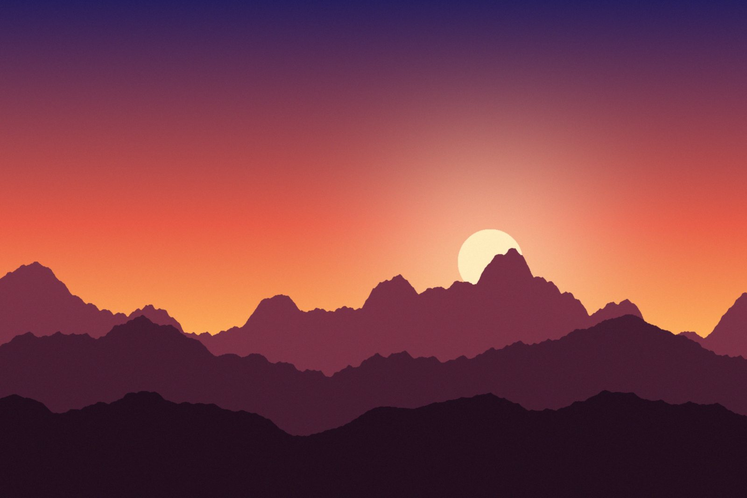
ashenos/design/prototype/media/sunset.jpg
