kkostyy/cyberdeck/base.stl

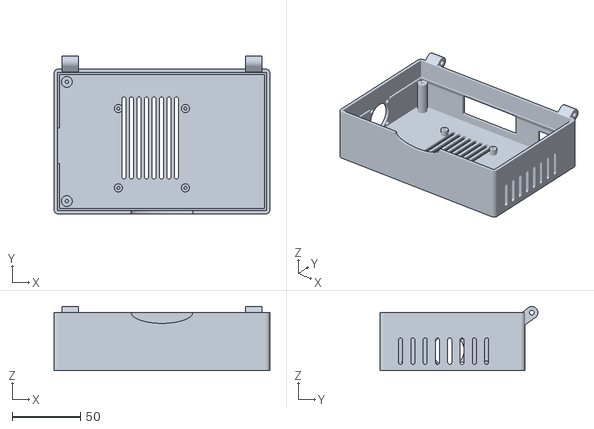
[picture p33: CAD file, 2026-10-28]
base.stl
158.0 x 115.5 x 46.9
