kkostyy/cyberdeck/верхняя часть/5 стиль v3 - рамка.stl

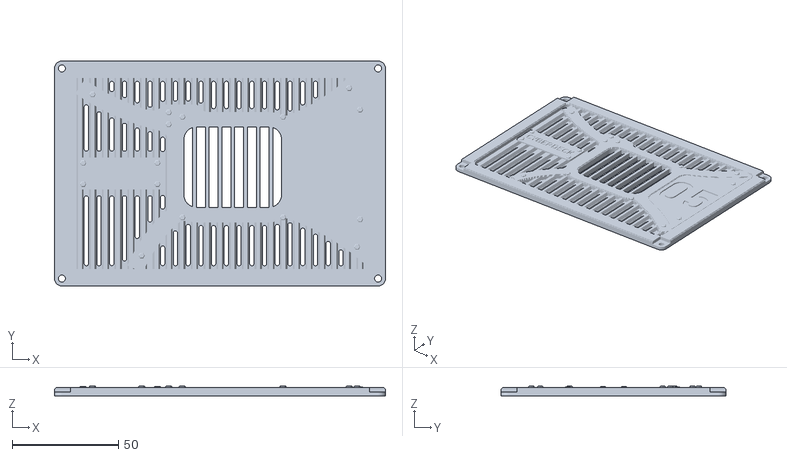
[picture p34: CAD file, 2026-11-06]
верхняя часть/5 стиль v3 - рамка.stl
156.0 x 106.0 x 4.80
