kkostyy/cyberdeck/верхняя часть/архив/5 стиль v2 - рамка.stl

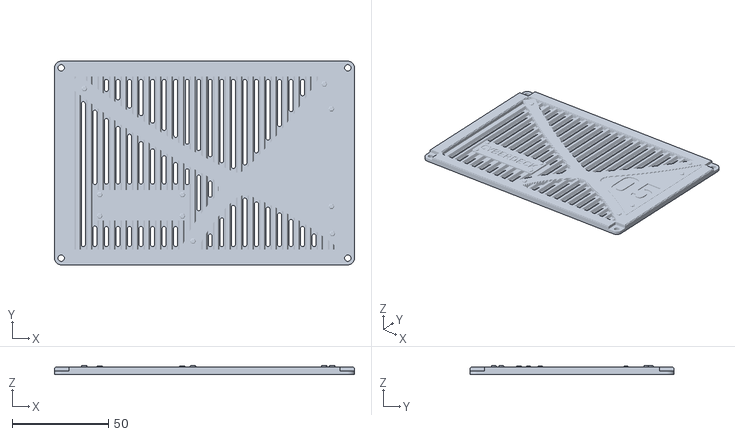
[picture p35: CAD file, 2026-11-06]
верхняя часть/архив/5 стиль v2 - рамка.stl
156.0 x 106.0 x 4.80
