kkostyy/cyberdeck/верхняя часть/электроника/Экран.stl

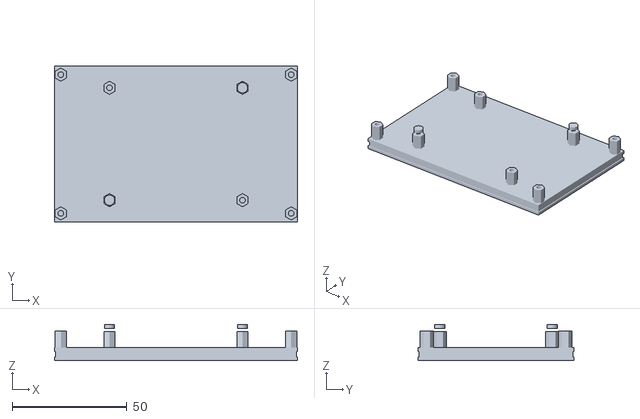
[picture p36: CAD file, 2026-11-06]
верхняя часть/электроника/Экран.stl
106.0 x 68.0 x 15.9
