kkostyy/cyberdeck/deck.stl

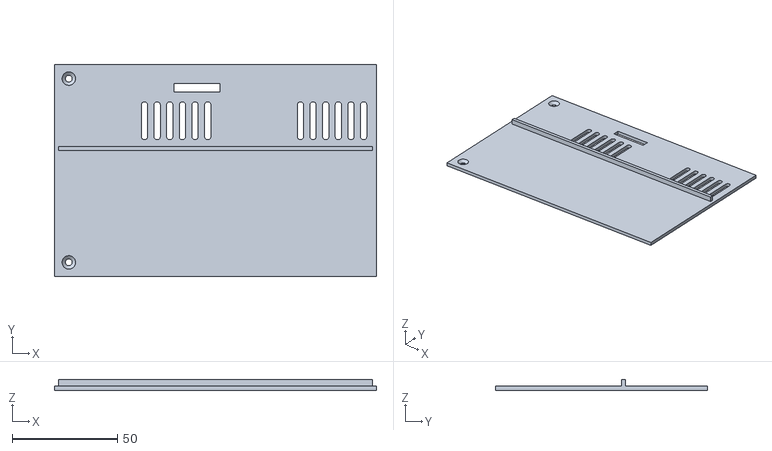
[picture p37: CAD file, 2026-10-28]
deck.stl
152.8 x 100.8 x 5.00
