kkostyy/cyberdeck/верхняя часть/5 стиль v3 - угол.stl

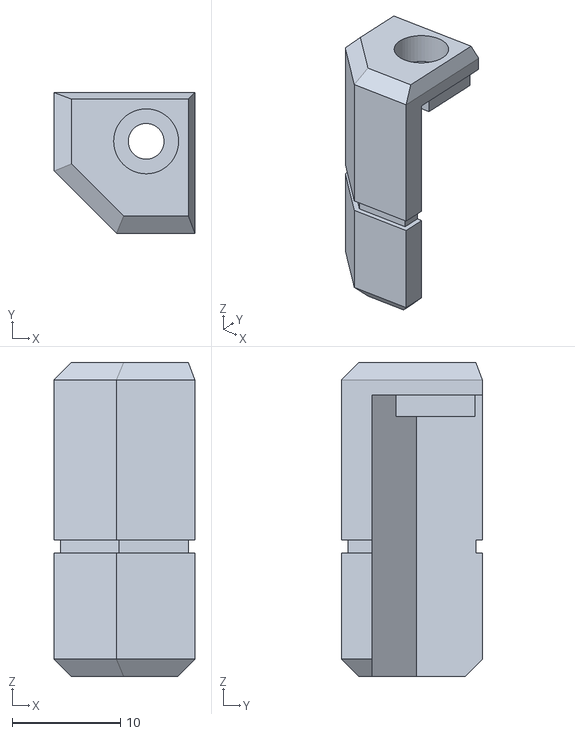
[picture p38: CAD file, 2026-11-06]
верхняя часть/5 стиль v3 - угол.stl
13.0 x 13.0 x 29.0
