kkostyy/cyberdeck/верхняя часть/архив/5 стиль v2 - крышка.stl

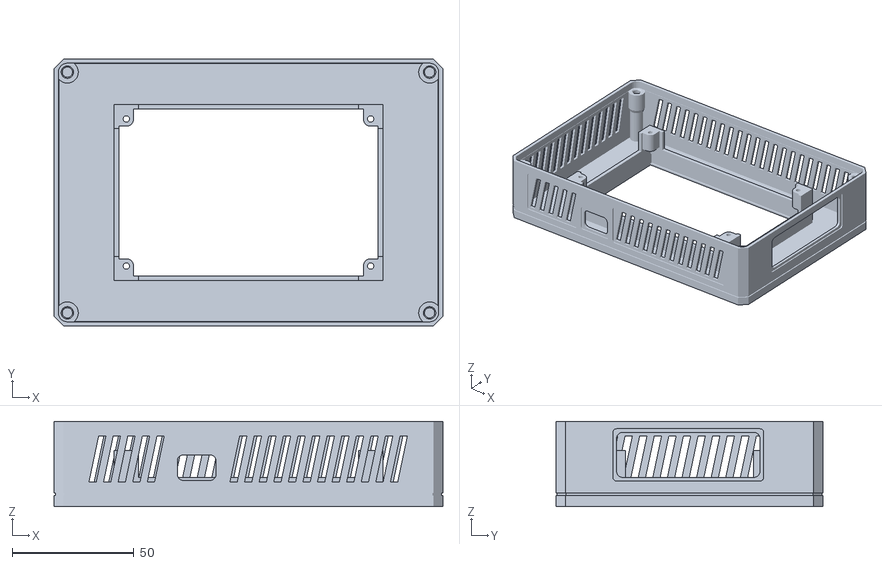
[picture p39: CAD file, 2026-11-06]
верхняя часть/архив/5 стиль v2 - крышка.stl
160.0 x 110.0 x 35.0
