kkostyy/cyberdeck/верхняя часть/электроника/Охлаждение.stl

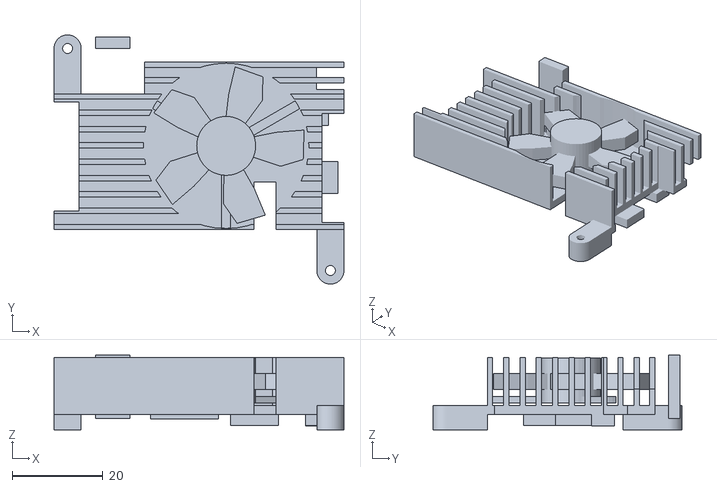
[picture p40: CAD file, 2026-11-06]
верхняя часть/электроника/Охлаждение.stl
64.0 x 55.0 x 16.5
