kkostyy/cyberdeck/lid_cover.stl

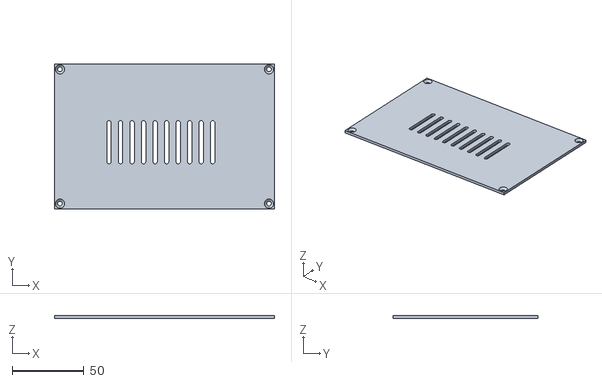
[picture p41: CAD file, 2026-10-28]
lid_cover.stl
152.8 x 100.8 x 2.00
