kkostyy/cyberdeck/верхняя часть/электроника/Raspberry Pi 4B.stl

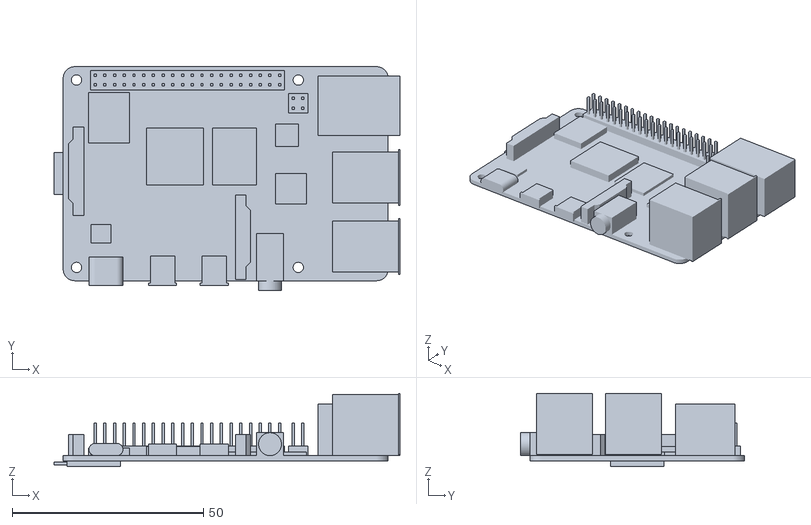
[picture p42: CAD file, 2026-11-06]
верхняя часть/электроника/Raspberry Pi 4B.stl
90.5 x 58.5 x 19.2
