kkostyy/cyberdeck/lid.stl

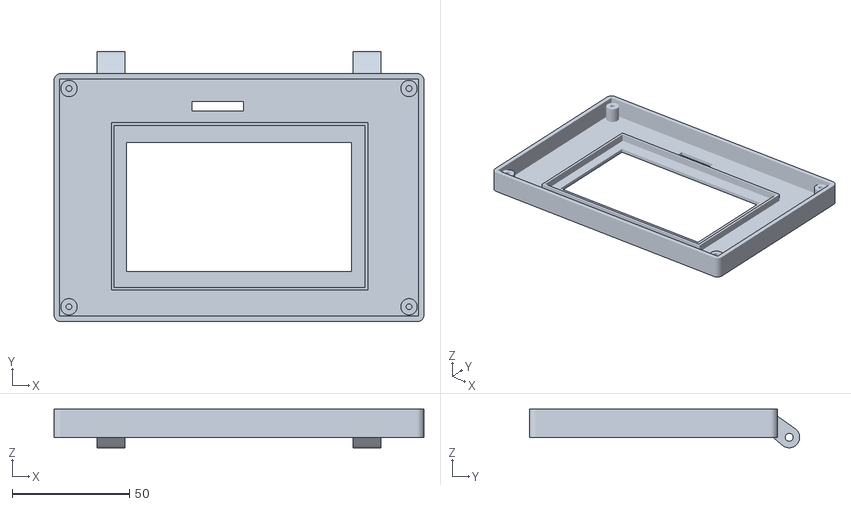
[picture p43: CAD file, 2026-10-28]
lid.stl
158.0 x 115.5 x 16.5
