kkostyy/cyberdeck/верхняя часть/proba v4.stl

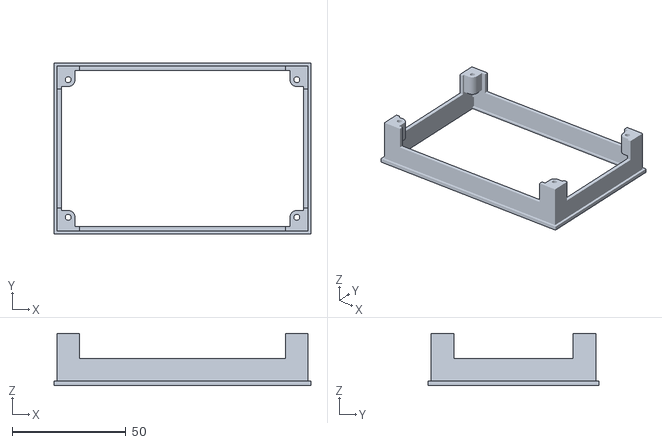
[picture p44: CAD file, 2026-11-05]
верхняя часть/proba v4.stl
113.0 x 75.0 x 23.0
