kkostyy/cyberdeck/верхняя часть/архив/верхняя часть.stl

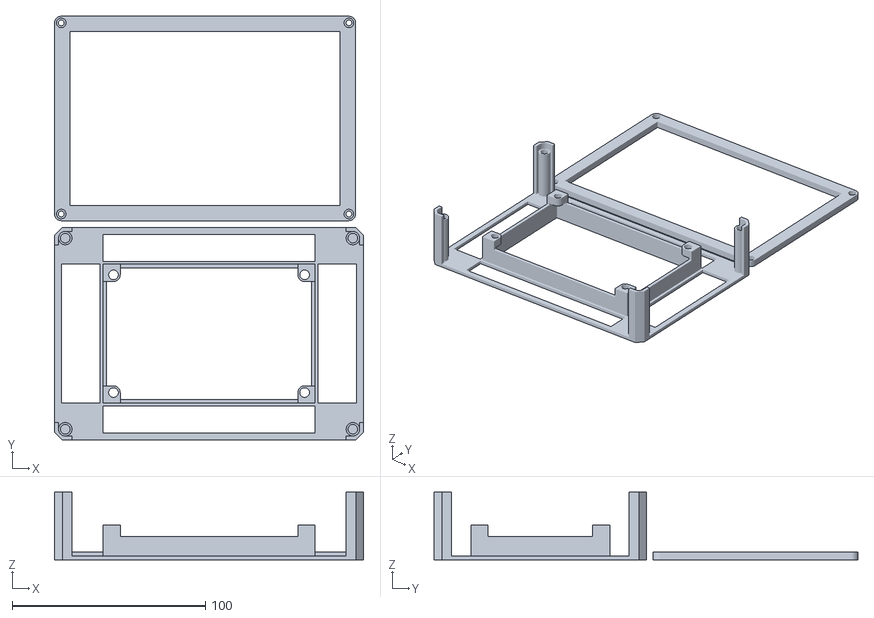
[picture p45: CAD file, 2026-11-05]
верхняя часть/архив/верхняя часть.stl
160.1 x 219.5 x 35.0
