kkostyy/cyberdeck/верхняя часть/архив/proba v3.stl

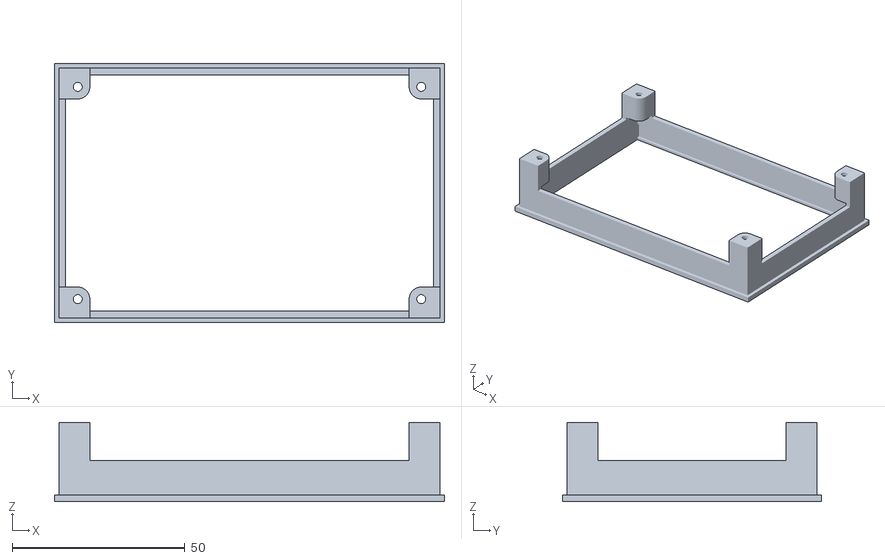
[picture p46: CAD file, 2026-11-05]
верхняя часть/архив/proba v3.stl
113.0 x 75.0 x 23.0
