kkostyy/cyberdeck/верхняя часть/архив/proba.stl

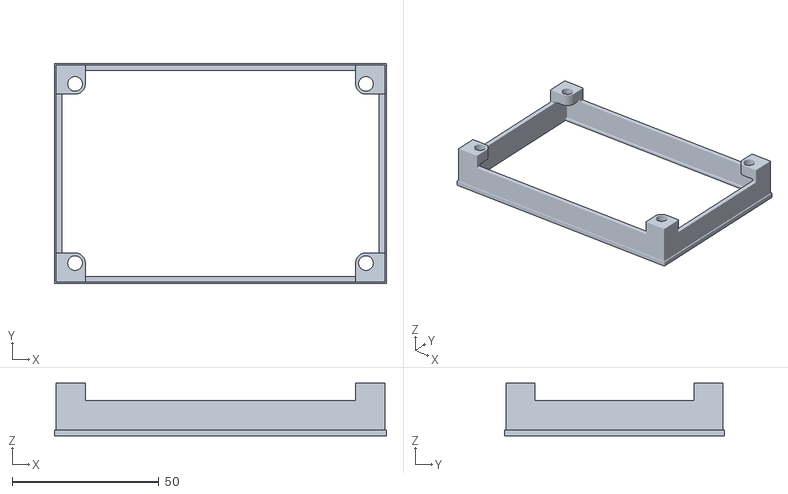
[picture p47: CAD file, 2026-11-05]
верхняя часть/архив/proba.stl
113.0 x 75.0 x 18.0
