kkostyy/cyberdeck/верхняя часть/архив/верхняя часть - крышка v6.stl

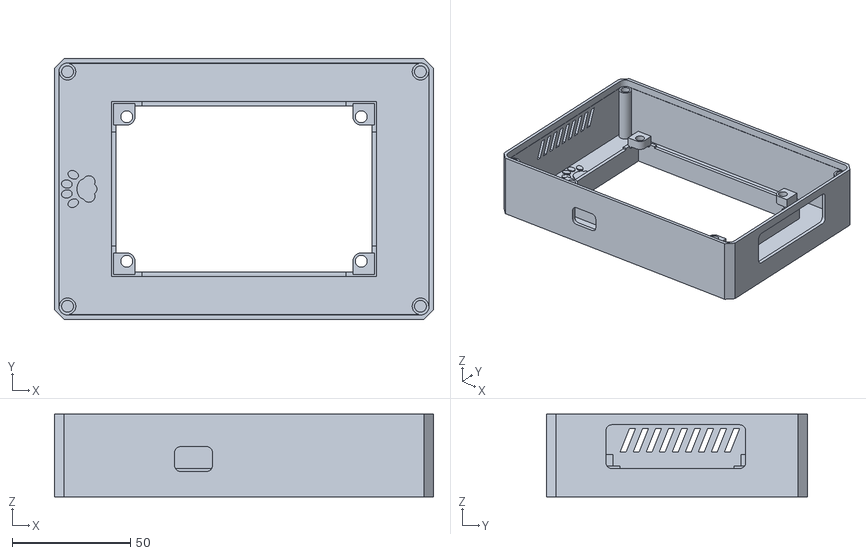
[picture p48: CAD file, 2026-11-05]
верхняя часть/архив/верхняя часть - крышка v6.stl
160.0 x 110.0 x 35.0
