kkostyy/cyberdeck/верхняя часть/архив/5 продув.stl

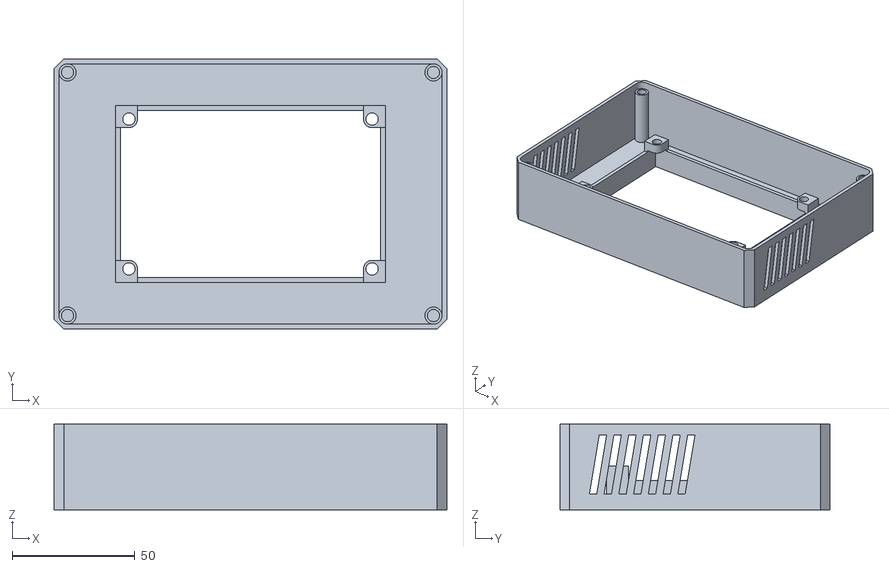
[picture p49: CAD file, 2026-11-05]
верхняя часть/архив/5 продув.stl
160.0 x 110.0 x 35.0
