kkostyy/cyberdeck/верхняя часть/архив/верхняя часть - крышка.stl

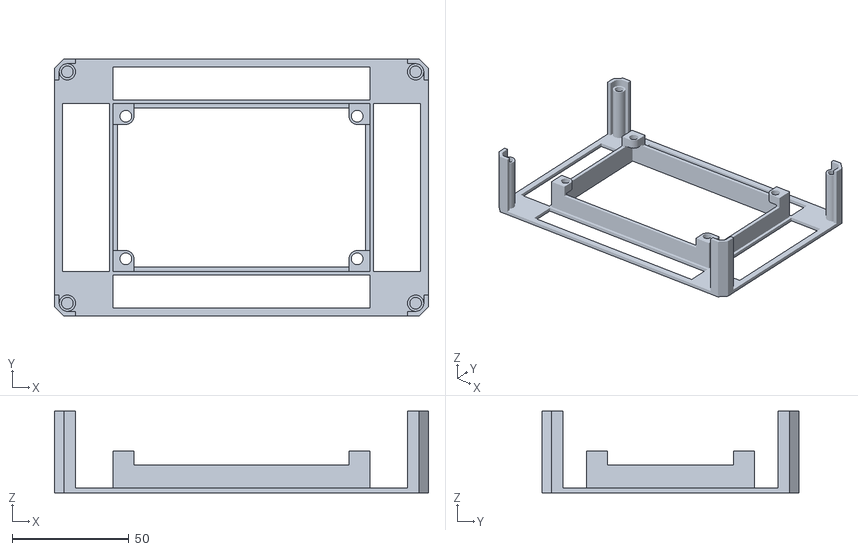
[picture p50: CAD file, 2026-11-05]
верхняя часть/архив/верхняя часть - крышка.stl
160.0 x 110.0 x 35.0
