kkostyy/cyberdeck/верхняя часть/архив/верхняя часть - рамка v3.stl

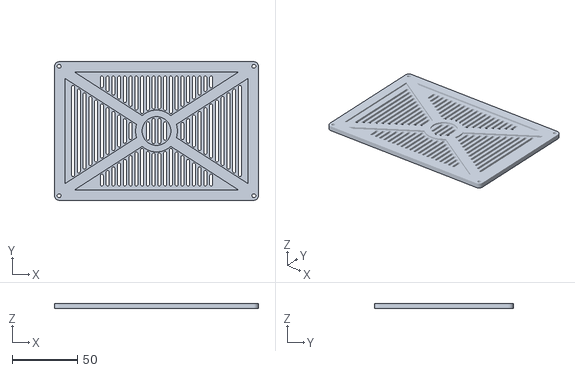
[picture p51: CAD file, 2026-11-05]
верхняя часть/архив/верхняя часть - рамка v3.stl
156.0 x 106.0 x 4.00
