kkostyy/cyberdeck/верхняя часть/архив/верхняя часть - рамка.stl

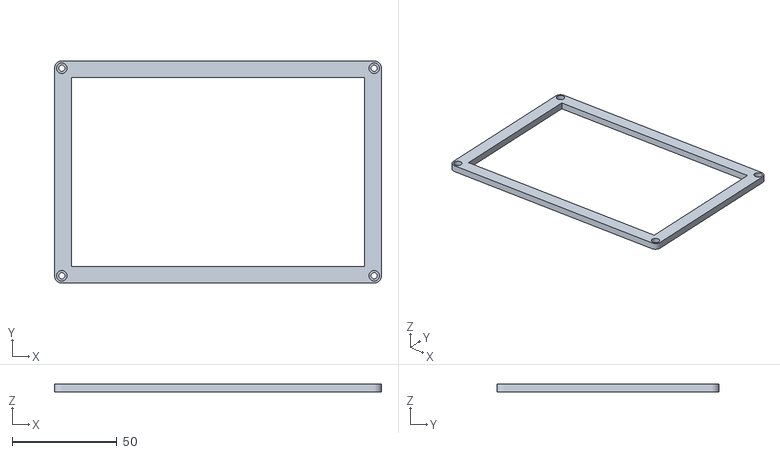
[picture p52: CAD file, 2026-11-05]
верхняя часть/архив/верхняя часть - рамка.stl
156.0 x 106.0 x 4.00
