kkostyy/cyberdeck/(list of files, cad)

Other CAD files:
верхняя часть/архив/5 продув v3.stl
cyberdeck_case.scad
верхняя часть/5 стиль v3.skp
верхняя часть/proba v4.skp
верхняя часть/архив/5 продув v2.skp
верхняя часть/архив/5 продув v2.stl
верхняя часть/архив/5 продув v3.skp
верхняя часть/архив/5 продув.skp
верхняя часть/архив/5 стиль - крышка.stl
верхняя часть/архив/5 стиль - рамка.stl
верхняя часть/архив/5 стиль - угол.stl
верхняя часть/архив/5 стиль v2.skp
верхняя часть/архив/5 стиль.skp
верхняя часть/архив/proba v2.stl
