kkostyy/cyberdeck/ashenos/airootfs/boot/config-ashenos.txt

# AshenOS — дополнения к /boot/config.txt (экран Waveshare 4,3" DSI без тача)
display_auto_detect=0
dtoverlay=vc4-kms-v3d
dtoverlay=vc4-kms-dsi-waveshare-800x480,disable_touch
# безопасное выключение кнопкой на GPIO3
dtoverlay=gpio-shutdown
# I2C для OLED-монитора
dtparam=i2c_arm=on
