kkostyy/cyberdeck/(commit log)

2026-10-28 Cyberdeck case: OpenSCAD model and STL parts
    Claude-Session: https://claude.ai/code/session_01CrgmZBKAFtGihULQii7pW6
    [base.stl, cyberdeck_case.scad, deck.stl, lid.stl, lid_cover.stl]
2026-11-05 Add IDEAS.md: what to do with the Pi 4 cyberdeck
    60+ ideas grouped by topic (portability, radio, networks, GPIO,
    offline AI, camera, navigation, electronics, fun, home, learning),
    each with hardware needed, rough price and difficulty, plus a
    starting roadmap and a shopping list.
2026-11-05 Add SketchUp upper part: lid, back frame, corner bumpers
    Latest models ("5 стиль": lid, frame, corner bumper, SketchUp assembly;
    proba v4 monitor mount), the Python sources that build them, and older
    versions in "верхняя часть/архив".
    [5 продув v2.skp, 5 продув v2.stl, 5 продув v3.skp, 5 продув v3.stl, 5 продув.skp, 5 продув.stl, 5 стиль - крышка.stl, 5 стиль - рамка.stl]
2026-11-06 Upper part v2: sunk M3 cap screws into heat-set inserts
    "5 стиль v2": corner screw M3x8 DIN 912 sits 0.3 mm below the bumper top
    and runs through bumper and a 2 mm frame corner into an M3x4x5 heat-set
    insert (Ø4.2 x 6 hole). Lid posts rebuilt as Ø9 with a 45° cone so the
    insert has 2.4 mm of wall. Previous "5 стиль" moved to архив.
    [5 стиль - крышка.stl, 5 стиль - рамка.stl, 5 стиль - угол.stl, 5 стиль v2 - крышка.stl, 5 стиль v2 - рамка.stl, 5 стиль v2 - угол.stl, 5 стиль v2.skp, 5 стиль.skp]
2026-11-06 Upper part v3: fan grille window for the Pi's Armor Lite cooler
    New back frame for the GeeekPi Armor Lite heatsink + fan on the Pi 4B:
    the corrugation ridges run on across a 46x38 window over the fan as an
    open grille, the X straps now meet a band round that window, a bolted
    buckle plate covers a pocket for the fan's GPIO plugs, "05" stands
    upright. Lid and corner bumper are unchanged from v2. Heatsink height
    (14 mm) is an estimate until measured. v2 moved to архив; preview added.
    [5 стиль v2 - крышка.stl, 5 стиль v2 - рамка.stl, 5 стиль v2 - угол.stl, 5 стиль v2.skp, 5 стиль v3 - крышка.stl, 5 стиль v3 - рамка.stl, 5 стиль v3 - угол.stl, 5 стиль v3.skp]
2026-11-06 Add electronics models: Raspberry Pi 4B, Armor Lite cooler, 4.3" display
    electronics.py builds fit-check models in lid coordinates: the Pi 4B
    from the official mechanical drawing (RP-008343-DS-1), the GeeekPi Armor
    Lite heatsink + 3510 fan from the maker's top-view picture and underside
    photo (height estimated at 16 mm, not published), and the Waveshare 4.3"
    DSI display (106x68 outline, layers and standoffs assumed). They are in
    "электроника/" as STL and inside "5 стиль v3.skp" as one group per
    device. skp_write.py now nests "Device - part" files as part groups in a
    device group and reuses materials. style.py takes the board top 14.0
    (official USB height 16.0) and the 16 mm c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
    [5 стиль v3.skp, Raspberry Pi 4B.stl, Охлаждение.stl, Экран.stl]
2026-11-09 Add AshenOS: Arch Linux ARM distro for the cyberdeck
    Color scheme, SDDM/KWin configs, DSI overlay, package list,
    SD image build script, shell concept screenshots and prototype sources.
    Claude-Session: https://claude.ai/code/session_01CrgmZCUh1vTb6tRRbHmNN7
    [config-ashenos.txt]
2026-11-09 AshenOS prototype: calendar, music and network popups follow serpantinum timings
    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
2026-11-10 AshenOS prototype: custom pet from user's own images, mapped to Claude states
    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
2026-11-10 AshenOS prototype: colour themes and accent tints in Settings
    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
2026-11-10 AshenOS prototype: Notes app, Downloads and Trash in the file manager, six new widgets
    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
2026-11-10 AshenOS prototype: working buttons and per-app settings, Browser app
    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
2026-11-10 AshenOS prototype: theme colours inside app windows and on the lock screen
    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
2026-11-11 AshenOS prototype: music panel follows the Music app, Settings apply volume, Wi-Fi, DND and night colour
    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
2026-11-11 AshenOS prototype: Settings drive animation speed, notification timing, island level indicator; bezel volume follows system
    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
2026-11-11 AshenOS: автонастройка на Raspberry Pi и окна в стиле macOS
    - /boot/ashenos.conf + ashenos-firstboot.service: раздел, имя, пользователь, Wi-Fi, язык, раскладки, SSH/VNC
    - ashenos-settings: все Параметры (18 тем + оттенок, обои, шрифты, клавиатура, экран, ночной цвет, звук, уведомления, анимации, блокировка, радио) + окно kdialog
    - применяются при входе в Plasma (autostart)
    - обои прототипа, генератор цветовых схем
    - прототип: светофор macOS, подъём окна п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
2026-11-11 Прототип: кнопки окна справа
    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
2026-11-11 Прототип: обложки папок (своя картинка и 9 материалов), кнопки окна у правого края
    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
2026-11-11 Прототип: Dynamic Island в цветах темы
    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
2026-11-11 Прототип: приложение «Карты» (поиск, избранное, маршруты, пробки, навигация)
    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
2026-11-11 Прототип: Монитор системы (батарея, ЦП, память, диск, службы, процессы, сеть)
    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
2026-11-11 Прототип: виджет «Обложка» и иконка музыки «пластинка в конверте»
    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
2026-11-11 Прототип: «Тест острова» работает и как отдельная доска (свой остров и уведомления)
    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
2026-11-11 Прототип: события острова показывают верхнюю панель и в полноэкранном режиме
    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
2026-11-11 Прототип: остров не прячется во весь экран, пока идёт звонок, запись, таймер или навигация
    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
2026-11-11 Остров-notch (фокус, панель «Сегодня / Неделя / Фокус», карточки контактов) и ashen-maps для дистрибутива
    - прототип: фокус-таймер и навигация в острове, задачи из чек-листов Заметок, аватары в уведомлениях
    - apps/ashen-maps: QML-карты на QtLocation (OSM, Nominatim, OSRM, GPS), лаунчер, .desktop, пакеты
    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
2026-11-11 Прототип: живые действия (звонок, запись, таймер, навигация) в панели острова, рабочие кнопки в Параметрах, без спама профиля «Игры»
    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
2026-11-11 Прототип: раздел «Динамический остров» в Параметрах, фокус можно выключить
    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
2026-11-11 Прототип: панель острова подстраивается, когда фокус и задачи выключены
    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
2026-11-11 Прототип: остров при многих живых действиях — максимум 3 значка и «+N», прокрутка в раскрытом виде, полка в панели «Сегодня»
    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
2026-11-11 Прототип: полка — остров виден при перетаскивании во весь экран, «Полка» больше не залипает
    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
2026-11-11 Прототип: Калькулятор, Блокнот, Фото и видео; Параметры в стиле macOS
    - Параметры: боковая панель и карточки как в macOS, история назад/вперёд, изменения применяются сразу
    - Калькулятор: обычный, научный, программист (HEX/DEC/OCT/BIN, биты), конвертер, история, память, клавиатура
    - Блокнот: вкладки, дерево файлов, текст/код с подсветкой (sh, py, qml/js, md, conf), поиск и замена, миникарта, открытие и скачивани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
2026-11-11 Прототип: файлы из Проводника открываются в приложениях, предпросмотр Markdown
    - Двойной щелчок или Enter в Проводнике: текст и скрипты — Блокнот, картинки — Фото, аудио — Музыка
    - Блокнот: режим «Просмотр» для .md с кликабельными задачами
    - Фото: импортированные файлы сохраняются между запусками (IndexedDB)
    - Dock показывает, какие приложения открыты; поиск находит Калькулятор, Блокнот, Фото, Ка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
2026-11-11 Прототип: адаптивный Dock и рабочие настройки дока
    - Размер значков подбирается под ширину экрана и число приложений, вместе с увеличением при наведении
    - Панель растёт по содержимому вместо фиксированных 720 px
    - Работают настройки «Размер значков», «Увеличение», «Ширина», «Скрытие» (Умное — при развёрнутом окне), «Точки», «Аудиоволна»
    - Параметры больше не присылают уведомление на к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
2026-11-11 Иконки приложений в едином пепельно-чёрном стиле
    - Dock: одинаковые плитки (пепельный градиент) и линейные значки одного веса
    - Тема слегка подкрашивает плитку и одну деталь значка своим акцентом
    - Поиск и миниатюры окон используют тот же пепельный фон
    - design/icons: набор из 17 SVG-иконок для дистрибутива
    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
2026-11-11 Иконки Dock в объёмном стиле прежних «Проводника» и «Музыки»
    - Вернул объёмную папку, пластинку в конверте и терминал; остальные значки сделаны так же — предметы из пепельного графита, бумаги и металла
    - Тема подкрашивает одну деталь каждого значка, основа остаётся пепельно-чёрной
    - design/icons: PNG 256×256 вместо прошлых линейных SVG
    Claude-Session: https://claude.ai/code/session_01Crg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
2026-11-11 Калькулятор в стиле iOS, окно своих пропорций
    - Окно калькулятора больше не растягивается на 16:10: обычный режим — узкое вертикальное окно 400×720, научный — широкое, как при повороте iPhone; при смене режима окно плавно меняет форму
    - Круглые клавиши (в широких режимах — капсулы), пепельные цифры, светлые функции, операции цветом темы с подсветкой; активная операция инвертируется
    - Тонкие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
2026-11-11 Прототип: интерфейс сам подстраивается под размер экрана
    - System определяет экран (авто, или выбор в Параметрах › Экран) и подбирает масштаб интерфейса: 1920×1080, 1440×900, 1280×800, 1024×600, 800×480
    - Верхняя панель, остров, Dock, окна, свёрнутые окна и экран блокировки считаются от реального размера
    - Виджеты рабочего стола сами раскладываются по сетке и уменьшаются, если не помещаются
    - На маленьких э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
2026-11-11 Прототип: жесты, привязка окон, рабочие столы и обзор окон
    - Перетаскивание окна к краю — половина экрана, в угол — четверть (с превью); приложение перестраивается под новую ширину
    - 4 рабочих стола: окна живут на своём столе, переключение жестом с бокового края или Ctrl+Alt+←/→
    - Обзор всех окон (F3, Ctrl+Alt+↑, длинный свайп снизу или свайп вниз по центру верхней панели), полоса рабочих столов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
2026-11-11 Прототип: общая файловая система, «Открыть с помощью…», поиск по содержимому
    - Сохранённые в Блокноте файлы и импортированные в Фото снимки появляются в нужной папке Проводника
    - Правый щелчок по файлу в Проводнике: «Открыть» и «Открыть с помощью» (Блокнот, Фото, Музыка)
    - Файл из Проводника можно перетащить прямо в окно Блокнота или Фото
    - Поиск в верхней панели ищет и внутри файло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
2026-11-11 Прототип: светлое оформление, системные звуки, пепельные иконки в приложениях
    - Параметры › Общее поведение › Оформление: Тёмное / Светлое / Авто (светлое днём); иконки Dock остаются пепельно-чёрными
    - Системные звуки (синтез, без файлов): щелчки кнопок, открытие и закрытие окон, уведомления, блокировка; настройки в Параметры › Звук
    - Значки разделов Параметров — пепельные плитки с цв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
2026-11-11 Дистрибутив: тема значков Ashen, чек-лист проверки на железе, статус проекта
    - usr/share/icons/ashen: пепельные объёмные значки (наследует Breeze Dark), включена в kdeglobals; кэш значков при сборке
    - docs/HARDWARE-CHECKLIST.md: проверка образа на Raspberry Pi 4 + Waveshare 4,3″ шаг за шагом
    - docs/STATUS.md: что есть в прототипе, что в образе, что проверено
    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
2026-11-11 Дистрибутив: Dynamic Island на Quickshell, значки Ashen не сбрасываются
    - usr/share/ashenos/island/shell.qml: остров сверху по центру — часы, музыка (MPRIS) с обложкой и кнопками, всплывающая громкость (PipeWire), батарея (UPower), таймер, полка для файлов (перетаскивание из Dolphin и обратно); акцент берётся из kdeglobals; IPC: toggle, timer, stopTimer, clearShelf
    - автозапуск в Plasma (etc/xdg/autostart/ashen-island.desktop), пакет upower
    - ashenos-settings больше не возвращает Breeze Dark: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
2026-11-11 Аватарка AshenOS: три варианта (уголь, остров, пепел)
    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
2026-11-11 Аватарка AshenOS: новые варианты — уголь с трещиной «A», тлеющий уголь, металлическая «A» с угольком
    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
2026-11-11 Дистрибутив: рабочие столы, привязка окон и жесты KWin как в прототипе, логотип
    - kwinrc: 4 рабочих стола, привязка к краям и четвертям, свайп снизу — обзор окон, свайп сверху — меню приложений
    - kglobalshortcutsrc: Ctrl+Alt+←/→ — рабочие столы, Ctrl+Alt+↑ — обзор (сочетания Meta тоже работают)
    - Логотип «Уголь с трещиной A»: /usr/share/pixmaps/ashenos.png (LOGO в os-release) и в README
    Claude-Session: https://claude.ai/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
2026-11-11 Прототип: виджеты «Калькулятор» и «Фото» на рабочем столе
    - Калькулятор считает прямо на рабочем столе (с подсказкой результата), щелчок по экрану открывает приложение
    - Фото-рамка листает снимки из медиатеки каждые 9 секунд, щелчок открывает «Фото»
    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
2026-11-11 Прототип: открытие и закрытие окон как на Mac, завершение приложений, в Dock только закреплённые
    - Окно вырастает из значка в Dock и при закрытии сворачивается обратно в него
    - Красная кнопка закрывает окно, но приложение остаётся запущенным (точка под значком); полностью — «Завершить» в меню значка или Ctrl+Q
    - Щелчок по значку запущенного приложения показывает его окно, а не закрывает
    - В Do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
2026-11-11 Прототип: умный диспетчер задач
    Приложения, процессы и фоновые службы; графики ЦП, памяти, температуры и батареи;
    советы (простаивающие приложения, тяжёлые вкладки, нагрев, индексация, батарея);
    «Освободить память», Ctrl+Shift+Esc, кнопки Перейти/Свернуть/Завершить.
    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
